Nishuy52/iex-coral-datalogger/images/steps/2023_indicator-on1000ufcap_900pixw.jpg

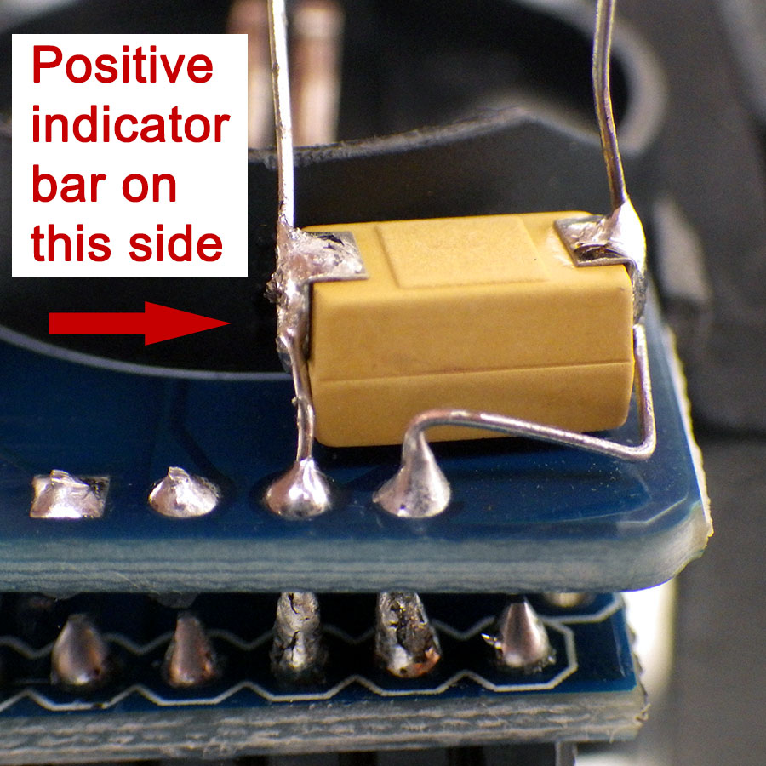
images/steps/2023_indicator-on1000ufcap_900pixw.jpg
