Nishuy52/iex-coral-datalogger/images/steps/pm4_clipresetswitch_900pixwsq.jpg

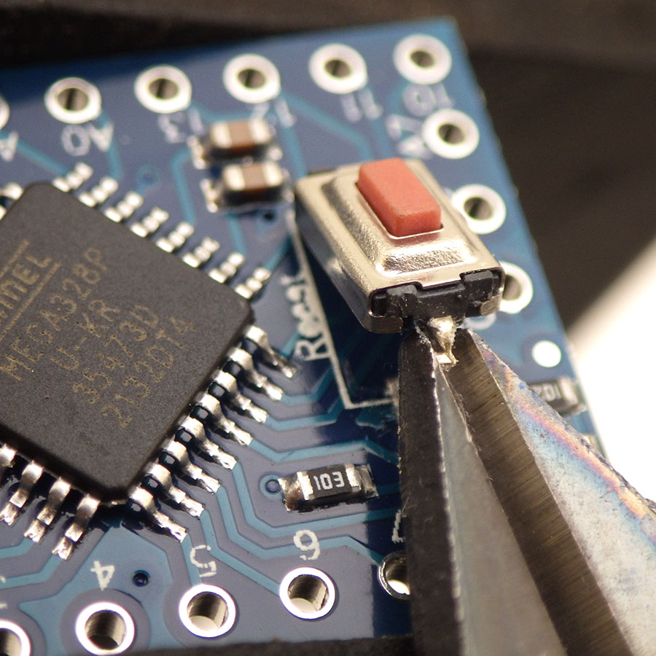
images/steps/pm4_clipresetswitch_900pixwsq.jpg
