Nishuy52/iex-coral-datalogger/images/steps/prom_headerpins_640pixw.jpg

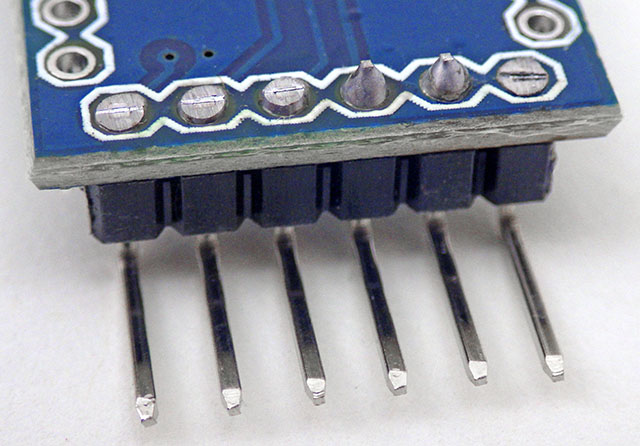
images/steps/prom_headerpins_640pixw.jpg
