Nishuy52/iex-coral-datalogger/2-Part_Logger_DEPLOY/2-Part_Logger_DEPLOY.ino

// 2-Part logger code by Edward Mallon - modified 2023 for e360 course at Northwestern University
// https://thecavepearlproject.org/2022/03/09/powering-a-promini-logger-for-one-year-on-a-coin-cell/
/*
This program supports an ongoing series of DIY 'Classroom Logger' tutorials from the Cave Pearl Project. 
The goal is to provide a starting point for self-built student projects in environmental monitoring.
This low power 2-module iteration runs from a CR2032 coin cell and uses EEprom memory to store sensor readings. 
Data download & logger control are managed through the IDE's serial monitor window at 500000 baud. 
The logger WILL NOT START until those serial handshakes are completed via a UART connection.
The most important rule to follow when adding new sensors is that this code can only accept 1, 2, 4, 8 or 16 sensorBytesPerRecord.
These 'powers of 2' fit in the I2C buffer AND divide evenly into the EEproms hardware page size to prevent page wrap-arounds.

The only library you MUST INSTALL for the minimum configuration of Promini & RTC module is LowPower [by LowPowerLab]
--------------------------------------------------------------------------------------------------------------------
this can be INSTALLED via the Library Manager or from https://github.com/LowPowerLab/LowPower

The following sensors require library installations before they can be used:
---------------------------------------------------------------------------
  BH1750 LUX sensor uses hp_BH1750  [by Stefan Armborst] via Lib Manager OR from https://github.com/Starmbi/hp_BH1750

  Sht30 Humidity sensor uses SHT85  [by Rob Tillaart] via Lib Manager OR from https://github.com/RobTillaart/SHT85/tree/master

  BMP280 uses BMP280_DEV  [by Martin Lindupp] which is available through the Lib Manager although the repo seems to have disappeared from github(?)

  BME280 (includes RH%) uses forcedBMX280  [by soylentOrange] which is available through the Lib Manager
  OR from https://github.com/soylentOrange/Forced-BMX280/tree/master NOTE that this library also works with the BMP280
  if you enable only recordBMEtemp_2byteInt and/or recordBMEpressure_2byteInt

*/

//++++++++++++++++++++++++++++++++++++++++++++++++++++++++++++++++++++++++++++++++   
//++++++++++++++++++++++++++++++++++++++++++++++++++++++++++++++++++++++++++++++++
// CURRENT 328p internal eeprom memory locations in use for start-up information
//++++++++++++++++++++++++++++++++++++++++++++++++++++++++++++++++++++++++++++++++   
//++++++++++++++++++++++++++++++++++++++++++++++++++++++++++++++++++++++++++++++++
/*
(0-3)     logger START TIME in unixtime (for reconstructiong timestamps later in sendSerial)
(4)       SampleIntervalMinutes
(5)       SampleIntervalSeconds
(6-9)     InternalReferenceConstant for calc. rail voltage from ADC in readRailVoltage
(10)      RTCagingOffset [adjusting by 3 compensates for ~ 1second of drift per month]
(12-15)   4byte UNIXtime of last time RTC was set by startMenu_setRTCtime - for drift tracking
(20-23)   NOT USED (yet) Sensor starting paramaters usually stored from (24) onwards

FOUR 100-CHARACTER 'text' info fields get stored in 328p internal eeprom:
Logger info:            64 to 164
Deployment info:        165 to 265
Calibration constants:  266 to 366
Site info:              367 to 467

These are output to screen by void setup_sendboilerplate2serialMonitor() when logger starts up
BUT you can store 'any' text in these fields, notes to self, normalization constants, etc
Note: we still have upper 512 bytes of 328p 1k eeprom availible for OLED screen fonts, etc.
// https://thecavepearlproject.org/2020/11/15/adding-two-oled-displays-to-your-arduino-logger-with-no-library/
*/

//++++++++++++++++++++++++++++++++++++++++++++++++++++++++++++++++++++++++++++++++   
//++++++++++++++++++++++++++++++++++++++++++++++++++++++++++++++++++++++++++++++++
// STEP0 :
// Create SENSOR definitions HERE to match the sensors you added to the logger
// Use these as global controls to enable/disable sensor code with #ifdef & #endif

// POWERS OF TWO rule: sensorBytesPerRecord for the enabled sensor combination MUST TOTAL 1,2,4,8 or 16
// IF you see a repeating error at download time it's probably because you violated that rule

//++++++++++++++++++++++++++++++++++++++++++++++++++++++++++++++++++++++++++++++++   
//++++++++++++++++++++++++++++++++++++++++++++++++++++++++++++++++++++++++++++++++

// LowestBattery & RTC_Temperature are the 2 byte 'base values' which are usually recorded with every sensor reading (as they require no extra sensor hardware beyond the logger itself)
#define logLowestBattery_1byte           // 1-byte (compressed): saves LowestBattery voltage recorded during EEprom saves
#define logRTC_Temperature_1byte         // 1-byte: the RTC's internal 0.25°C resolution temperature sensor

//Pressure sensor:
//#define readBMP280_Temp_2byte            // 2-bytes  // IF you enable all three BMP or BME outputs
//#define readBMP280_Pressure_2byte        // 2-bytes  // you will need two more bytes for an 8-byte record: try adding logLowestBattery_1byte & logRTC_Temperature_1byte 
//#define recordBMP280_Altitude_2byte      // 2-bytes: calculated by library

#define readD7resistorwD6ref_2byte       // NTC? 2-bytes: ohms // for explanation of the method for reading analog resistance with digital pins see
//#define readD9resistorwD6ref_2byte       // LDR? 2-bytes: ohms // https://thecavepearlproject.org/2019/03/25/using-arduinos-input-capture-unit-for-high-resolution-sensor-readings/
                                           // 2022 note: 10k refference resistor on D6, NTC on D7, 300Ω on D8, LDR on D9 - does not match newer 2023 e360 NTC connections
 //Light/Lux sensor:
#define readBh1750_LUX_2byte             // 2-bytes: NOTE: raw sensor output gets converted to Lux during download

//Infrared Motion sensor:                  // AM312 typically adds 10-15uA to sleep current
//#define PIRcountPerInterval_2byte  // 2-bytes:  PIR is just another interrupt generating sensor, saves # of PIR HIGH events in a specified sample interval. Do not enable this with PIRtriggersReadings_4byte - choose one or the other

//#define PIRtriggersReadings_4byte          // 4-bytes for Unix Timestamp saved every pass: Do not enable this with PIRcountPerInterval_2byte - choose one or the other
// DOES NOT use the regular RTC-alarm based sampling interval but instead records the seconds elapsed between EVERY PIR trigger event in a uint32_t long variable [uint16_t would overflow at ~18 hours]
// PIRtriggersReadings_4byte usually enabled with four other bytes of sensor data [for a total of 8 bytes per record] OR with another 12 bytes of sensor data for a total of 16 bytes per record.
// WARNING this can use alot of memory very quickly if PIR is triggered frequently! - recommend use with larger eeprom memory attached


//#define logCurrentBattery_2byte          // RARELY USED - not 1byte compressed like LowestBattery, primarily included as a powers-of-2 balancing option
//#define logFreeVariableMemory_2byte      // RARELY USED - primarily included as a powers-of-2 rule balancing option that does not rely on any external sensors

//#define readSi7051_Temp_2byte            // 2-bytes: used for NTC calibration - does not require a library, functions for si7051 at end of program

//#define readSht3x_Temp_2byte             // 2-bytes
//#define readSht3x_Humidity_2byte         // 2-bytes

#define recordBMEtemp_2byteInt           // 2-byte NOTE: works with both BMP & BME
//#define recordBMEpressure_2byteInt       // 2-byte NOTE: works with both BMP & BME
//#define recordBMEhumidity_2byteInt       // 2-byte ONLY if BME 280 connected!

//#define OLED_64x32_SSD1306               // not a sensor, but enabled with define to include needed library - requires 1000uF rail cap to smooth noise from 1306 charge pump!

// Default EEprom: 0x57 & 4096 here saves data into the 4k eeprom on the RTC module:
//#define EEpromI2Caddr 0x57                    // Run a bus scanner to check where your eeproms are https://github.com/RobTillaart/MultiSpeedI2CScanner
//#define totalBytesOfStorage 4096              // Default: 0x57 / 4096bytes to use the 4k eeprom on the RTC module

// Saving to an external 64k AT24C512 I2C EEprom module (Appendix B):
#define EEpromI2Caddr 0x50                    // Run a bus scanner to check where your eeproms are https://github.com/RobTillaart/MultiSpeedI2CScanner
#define totalBytesOfStorage 65536             // AT24C512 64k module

// the Red LED on D13 gets used if BOTH of the following LED #define statements are commented out
//#define LED_r9_b10_g11_gnd12               // enables code for RGB indicator LED // expects a 1k limit resistor on shared GND!
#define LED_GndGB_A0_A2                  // For 2022 2-module build with NO breadboards: red channel leg on led cut, A0gnd Green A1, blue A2, default Red on d13 left in place

#include <Wire.h>       // I2C bus coms library: RTC, EEprom & Sensors
#include <EEPROM.h>     // note: requires default promini bootloader (ie NOT optiboot)
#include <avr/power.h>  // library for shutting down 328p chip peripherals to lower runtime current
#include <avr/sleep.h>  // provides SLEEP_MODE_ADC to lower current during ADC readings in readRailVoltage() function
#include <LowPower.h>   // this library NEEDS TO BE INSTALLED via the LIBRARY MANAGER for interval & battery recovery sleeps
                        // OR can be downloaded from LowPowerLab's repo (https://github.com/LowPowerLab/LowPower)

// Ref, Interval & Echo are reset via serial monitor input - so the values here don't matter
//-------------------------------------------------------------------------------------------------
int32_t InternalReferenceConstant = 1126400;  // default = 1126400L = 1100mV internal vref * 1024 // gets changed in setup via serial menu input option later
                                              // adding/subtracting 400 from the constant raises/lowers the 'calculated' result from readRailVoltage() by ~1 millivolt,
                                              // simply read the rail with a DVM while running on UART power and change the constant until the calculation is accurate
int8_t RTCagingOffset = 0;                    // stores -127 to +128 in the same two complement format that the register in the RTC uses
uint8_t SampleIntervalMinutes = 15;           // Allowed values: 1,2,3,5,10,15,20,30 for both - must divide equally into 60!
uint8_t SampleIntervalSeconds = 0;            // minutes must be zero for intervalseconds, seconds must be zero for intervalMinutes
                                              // NOTE: Make sure your sensor readings don't take longer than your sample interval!
                                              // If you over-run your alarm because the sensor took too long you will have to wait 24hours for next wakeup

bool ECHO_TO_SERIAL = false;                  // true enables multiple print statements throughout the code via if(ECHO_TO_SERIAL){} // also starts the run with no interval sync delay so timestamps are misaligned
bool displayMoreOptions = false;              // Flag toggle between Setup and Runtime Menus in void setup_displayStartMenu()

// most VARIABLES below this point stay the SAME on all machines:
//---------------------------------------------------------------------------
#define fileNAMEonly (strrchr(__FILE__, '/') ? strrchr(__FILE__, '/') + 1 : strrchr(__FILE__, '\\') ? strrchr(__FILE__, '\\') + 1 : __FILE__) //from: https://stackoverflow.com/questions/8487986/file-macro-shows-full-path
const char compileDate[] PROGMEM = __DATE__;  //  built-in function in C++ makes text string: Jun 29 2023
const char compileTime[] PROGMEM = __TIME__;  //  built-in function in C++ makes text string: 10:04:18

#define EEpromI2Caddr 0x50                    // Run a bus scan to check where your eeproms are https://github.com/RobTillaart/MultiSpeedI2CScanner
#define totalBytesOfStorage 65536       // external AT24C512 64k EEprom module
// Default onboard EEprom on RTC module: 0x57 & 4096 // 32k Module: 0x50 & 32768
uint8_t sensorBytesPerRecord = 0;             // INCREMENTED at the beginning of setup to match #defined sensors. MUST divide evenly into EEprom Page buffer AND fit inside I2C buffer
uint32_t EEmemPointer = 0;                   // counter that advances through the EEprom memory locations by sensorBytesPerRecord at each pass through the main loop

#ifdef logFreeVariableMemory_2byte
uint16_t freeVariableMemory = 0;              // for debugging or powers of two memory balancing
#endif

//defines & variables for ADC & readRailVoltage() function
//------------------------------------------------------------------------------
uint16_t CurrentBattery = 0;
uint16_t LowestBattery = 5764;                                  
uint16_t systemShutdownVoltage = 2795;        // MUST be > BrownOutDetect default of 2775mv (which is also the EEprom voltage limit)
byte default_ADCSRA,default_ADMUX;            // stores default ADC control register settings for peripheral shut down
byte set_ADCSRA_2readRailVoltage, set_ADMUX_2readRailVoltage; // stores custom settings for readRailVoltage() via 1.1 internal band gap reference
volatile uint8_t adc_interrupt_counter;       // incremented in readADCLowNoise ISR to calculate average of multiple ADC readings
#define NOP __asm__ __volatile__ ("nop\n\t")  //https://forum.arduino.cc/index.php?topic=43333.0

//defines & variables for DS3231 RTC
//------------------------------------------------------------------------------
#define RTC_TempRangeOffset 80  // 80 shifts 63degree range of 1byte encoding by +(80/4)C to handle COLD temps: -20C to +43.5C
                                // change this Offset to 40 for WARMER climate deployments to set the range to: -10C to +53.5C

#define rtcAlarmInputPin 2                    // DS3231's SQW output is connected to interrupt0 pin D2 on the ProMini
#define DS3231_ADDRESS     0x68               // this is the I2C bus address of our RTC chip
#define DS3231_STATUS_REG  0x0F               // reflects status of internal operations
#define DS3231_CONTROL_REG 0x0E               // enables or disables clock functions
#define DS3231_TMP_UP_REG  0x11               // temperature registers (upper byte 0x11 & lower 0x12) gets updated every 64sec
#define DS3231_AGING_OFFSET_REG 0x10          // Aging offset register
uint8_t AlarmSelectBits;                      // sets which parts of time to use or ignore for nxt alarm // ALRM1_SET bits and ALRM2_SET are 0b1000 and 0b0111 respectively.
uint8_t t_second,t_minute,t_hour,t_day,t_month;     // current time variables populated by calling RTC_DS3231_getTime()
uint16_t t_year;                              //current year //note: yOff = raw year to which you need to add 2000
uint8_t Alarmday,Alarmhour,Alarmminute,Alarmsecond; // calculated variables for setting next alarm
volatile boolean rtc_INT0_Flag = false;       // used in startup time sync delay //volatile because it's changed in an ISR // rtc_d2_alarm_ISR() sets this boolean flag=true when RTC alarm wakes the logger
int16_t rtc_TEMP_degCx4 = 0;                  // NOTE saved rtc_TEMP is reduced to only one BYTE
bool DS3231_PowerLossFlag = false;

// temporary 'buffer' variables only used during calculations
//------------------------------------------------------------------------------
bool booleanBuffer;                           // boolean for functions that return a true/false or 1/0
uint8_t byteBuffer1 = 9;                      // 1-byte (8 bit) type = unsigned number from 0 to 255
uint8_t byteBuffer2 = 9;                      // note: uint8_t is the same as byte variable type
int16_t int16_Buffer = 9999;                  // 2-byte from -32,768 to 32,767
uint16_t uint16_Buffer= 9999;                 // 2-byte from 0 to 65535
int32_t int32_Buffer = 9999;                  // 4-byte from -2,147,483,648 to 2,147,483,647
uint32_t uint32_Buffer= 9999;                 // 4-byte from 0 to 4,294,967,295 //used for millis() timing
float floatBuffer = 9999.99;                  // for float calculations
uint8_t hiByte,loByte;                        // for splitting 16-byte integers during EEprom save

//+++++++++++++++++++++++++++++++++++++++++++++++++++++++++++++++++++++++++++++++   
//+++++++++++++++++++++++++++++++++++++++++++++++++++++++++++++++++++++++++++++++
// STEP1 : #include sensor libraries, create GLOBAL variables, #defines etc. HERE
//+++++++++++++++++++++++++++++++++++++++++++++++++++++++++++++++++++++++++++++++   
//+++++++++++++++++++++++++++++++++++++++++++++++++++++++++++++++++++++++++++++++

#if defined(PIRcountPerInterval_2byte) || defined(PIRtriggersReadings_4byte)
uint16_t d3_INT1_eventCounter = 0;
volatile boolean d3_INT1_Flag = false; 
#endif

#ifdef PIRtriggersReadings_4byte
//--------------------------------
uint32_t currentPIRtriggerTime;      // not saved, but calculated for specific lab activities
uint32_t previousPIRtriggerTime;     // not saved, but calculated for specific lab activities
uint32_t d3_INT1_elapsedSeconds = 0; // not saved, but calculated for specific lab activities
#endif

#ifdef readD7resistorwD6ref_2byte 
//--------------------------------
  uint32_t D7resistor_NewReading;           // max of 65535 limits our ability to measure 10kNTC at temps below zero C!
  // although the timing code is capped at 65535 the variable needs to be uint32_t to accomodate
  // because clock ticks are about 1/3 of actual ohms & calculation can reach values of about 150k ohms 
#endif

#ifdef readD9resistorwD6ref_2byte 
//--------------------------------
  uint32_t D9resistor_NewReading;           // 65535 limit
#endif
#if defined(readD7resistorwD6ref_2byte) || defined(readD9resistorwD6ref_2byte)
//------------------------------------------------
  #define referenceResistorValue 10000UL    //  ARBITRARY value that should be 'close' to actual ohms but precise is not required  //https://hackingmajenkoblog.wordpress.com/2016/08/12/measuring-arduino-internal-pull-up-resistors/
  volatile boolean triggered;               //  volatiles needed for all digital pin reading of resistance:        
  volatile uint16_t timer1CounterValue;     //  prepareForInterrupts(), ISR (TIMER1_OVF_vect), ISR (TIMER1_CAPT_vect), ReadD6riseTimeOnD8
#endif

#ifdef readBh1750_LUX_2byte 
//------------------------------------------------------------------------------
  #include <hp_BH1750.h>                    // by Stefan Armborst via Lib Manager OR from https://github.com/Starmbi/hp_BH1750 returns the sensor to sleep automatically after each read & supports auto-ranging.
  hp_BH1750 bh1750;                         // Instantiate a BH1750FVI library object
  uint16_t lux_BH1750_RawInt;               // raw reading before conversion to lux // 2-byte, 0 to 65535
  #define Bh1750_Address 0x23
#endif

#if defined(readSht3x_Temp_2byte) || defined(readSht3x_Humidity_2byte)
//---------------------------------------------------------------
// https://sensirion.com/media/documents/213E6A3B/63A5A569/Datasheet_SHT3x_DIS.pdf
// SHT30 Accuracy ±0.2°C, ±2%RH
// idle state(single shot mode@3v) 0.2uA,  Supply current: Measuring 600uA, Heater power 33mW 
// Soft reset time 1.5 ms, Measurement duration 15 ms (slow)  4 ms (fast)
// The SHT85 is protocol in this library is compatible with the SHT3x series of sensors

  #include <SHT85.h> // https://github.com/RobTillaart/SHT85/tree/master
  #define ShtRH_ADDRESS   0x44              // The SHT3x has two I2C address options: 0x44 & 0x45
  float Sht3x_Temp_degC,Sht3x_RH_percent;   // floats converted to integer before saving - preserving two decimal places
  SHT85 sht3x(ShtRH_ADDRESS);
  //uint16_t Sht3x_Temp_RawInt,Sht3x_RH_RawInt; //library also supports raw integer output
#endif

#if defined(readBMP280_Temp_2byte) || defined(readBMP280_Pressure_2byte) || defined(recordBMP280_Altitude_2byte)
//-----------------------------------------------------------------------------------
  #include <BMP280_DEV.h>                   // Include the BMP280_DEV.h library  // NOTE: this library has disappeared from github?
  BMP280_DEV bmp280;                        // Instantiate (create) a BMP280_DEV object and set-up for I2C operation
  #define BMP280_Address 0x76
  float Bmp280_Temp_degC, Bmp280_Pr_mBar, Bmp280_altitude_m;  // Variables for sensor output
  // NOTE these floats get converted into 16-bit ints before saving to EEprom
#endif

#if defined(recordBMEtemp_2byteInt) || defined(recordBMEpressure_2byteInt) || defined(recordBMEhumidity_2byteInt)
//-----------------------------------------------------------------------------------
  #include <forcedBMX280.h>  // install this through the library manager in the IDE
  // from https://github.com/soylentOrange/Forced-BMX280/blob/master/examples/BME280_full_example/BME280_full_example.ino
  // ctrl_meas - see datasheet section 5.4.5 // forced mode: ctrl_meas[0..1] 0b01 (0b11 for normal and 0b00 for sleep mode)
  // pressure oversampling x 1: ctrl_meas[4..2] 0b001
  // temperature oversampling x 1: ctrl_meas[7..5] 0b001
  // humidity does not have oversampling
  
  ForcedBME280 climateSensor = ForcedBME280();
  int32_t Bmx_temperature;  // current temperature with 2 decimal places ALREADY embedded in the integer by the library
  uint32_t Bmx_pressure;    // current pressure           "
  uint32_t Bme_humidity;    // current humidity           "
#endif

#ifdef readSi7051_Temp_2byte 
//------------------------------------------------------------------------------
  // we are not using a library - init and read functions for si7051 at end of program
  uint16_t TEMP_si7051=0;                  // NOTE sensors output overruns this uint16_t at 40C!
  #define Si7051_Resolution 0b00000000     // 0b00000000 = 14-bit (0.01 C rez), 13 bit = 0b10000000 (0.02 C rez), 12 bit = 0b00000001 (0.04 C rez),11 bit = 0b10000001 (0.08 C rez)
  #define Si7051_Address 0x40
#endif

#ifdef OLED_64x32_SSD1306
//------------------------------------------------------------------------------
#include <SSD1306Ascii.h>       // https://github.com/greiman/SSD1306Ascii
#include <SSD1306AsciiWire.h>   // tells SSD1306Ascii.h to use default wire library
#define oled_I2C_Address 0x3C   // 0X3C+SA0 can be 0x3C or 0x3D
SSD1306AsciiWire oled;          // declare oled object
#endif


//======================================================================================================================
//======================================================================================================================
//======================================================================================================================
//*   *   *   *   *   *   *   *   *   *   *   SETUP   *   *   *   *   *   *   *   *   *   *   *   *   *   *   *   *   * 
//======================================================================================================================
//======================================================================================================================
//======================================================================================================================
// NOTE: problems in setup usually call the error_shutdown() function which shuts down the logger

void setup () {

  // --- early serial init: bring up the UART BEFORE any I2C so a stuck bus
  //     (e.g. a miswired sensor holding SDA/SCL low) can't blank the monitor ---
  Serial.begin(500000);                          // 500000 baud = max for 8MHz
  Serial.println(F("\nBooting... initialising I2C / RTC"));  Serial.flush();

//+++++++++++++++++++++++++++++++++++++++++++++++++++++++++++++++++++++++++++++++
//+++++++++++++++++++++++++++++++++++++++++++++++++++++++++++++++++++++++++++++++
// STEP2 : Adjust the sensorBytesPerRecord variable to match the #bytes in your
// sensor variables that will be saved to EEprom at each sampling interval
// sensorBytesPerRecord must be 1,2,4,8 or 16 bytes because of EEprom page boundaries
//+++++++++++++++++++++++++++++++++++++++++++++++++++++++++++++++++++++++++++++++   
//+++++++++++++++++++++++++++++++++++++++++++++++++++++++++++++++++++++++++++++++
  
  #ifdef logLowestBattery_1byte
    sensorBytesPerRecord = sensorBytesPerRecord + 1;            // NOW INDEX-compressed to 1-Byte [with slight loss of resolution]
  #endif
  #ifdef logRTC_Temperature_1byte
    sensorBytesPerRecord = sensorBytesPerRecord + 1;            // NOW INDEX-compressed to 1-Byte of eeprom storage
  #endif

  #ifdef PIRcountPerInterval_2byte
    sensorBytesPerRecord = sensorBytesPerRecord + 2;            //  two-byte integer counts Rising of output channel of PIR sensor
  #endif

  #ifdef PIRtriggersReadings_4byte
    sensorBytesPerRecord = sensorBytesPerRecord + 4;            //  4-byte integer: d3_INT1_elapsedSeconds
  #endif
  
  #ifdef readD7resistorwD6ref_2byte 
    sensorBytesPerRecord = sensorBytesPerRecord + 2;            //  two-byte integer: NTC ohms
  #endif
  #ifdef readD9resistorwD6ref_2byte
    sensorBytesPerRecord = sensorBytesPerRecord + 2;            //  two-byte integer: LDR ohms
  #endif

  #ifdef readBh1750_LUX_2byte
    sensorBytesPerRecord = sensorBytesPerRecord + 2;           // two-byte integer for RAW reading before conversion to lux
  #endif
 
  #ifdef readSht3x_Temp_2byte
    sensorBytesPerRecord = sensorBytesPerRecord + 2;            // two-byte integer 
  #endif
  #ifdef readSht3x_Humidity_2byte
    sensorBytesPerRecord = sensorBytesPerRecord + 2;            // two-byte integer 
  #endif
  
  #ifdef readBMP280_Temp_2byte
    sensorBytesPerRecord = sensorBytesPerRecord + 2;            // two-byte integer 
  #endif
  #ifdef readBMP280_Pressure_2byte
    sensorBytesPerRecord = sensorBytesPerRecord + 2;            // two-byte integer 
  #endif
  #ifdef recordBMP280_Altitude_2byte
    sensorBytesPerRecord = sensorBytesPerRecord + 2;            // two-byte integer 
  #endif

  #ifdef recordBMEtemp_2byteInt
    sensorBytesPerRecord = sensorBytesPerRecord + 2;            // two-byte integer 
  #endif
  #ifdef recordBMEpressure_2byteInt
    sensorBytesPerRecord = sensorBytesPerRecord + 2;            // two-byte integer 
  #endif
  #ifdef recordBMEhumidity_2byteInt
    sensorBytesPerRecord = sensorBytesPerRecord + 2;            // two-byte integer 
  #endif
  
  #ifdef logCurrentBattery_2byte
    sensorBytesPerRecord = sensorBytesPerRecord + 2;            // two-byte integer
  #endif
  #ifdef logFreeVariableMemory_2byte
    sensorBytesPerRecord = sensorBytesPerRecord + 2;            // two-byte integer
  #endif
  
  #ifdef readSi7051_Temp_2byte
    sensorBytesPerRecord = sensorBytesPerRecord + 2;            // two-byte integer  
  #endif
  

// General Startup housekeeping: Set UNUSED digital pins to a known state at startup to reduce current & noise
//------------------------------------------------------------------------------------------------------------

  // set UNUSED digital pins to INPUT/HIGH so EMI noise does not toggle the pin & draw current
    for (int i = 3; i <=8; i++) { pinMode(i,INPUT); digitalWrite(i,HIGH);} 

  #ifdef LED_r9_b10_g11_gnd12                       // we will use INPUT & PULLUP resistor to PIP the leds to reduce current
    for (int i = 9; i <=12; i++) { pinMode(i, INPUT); digitalWrite(i, LOW); }
    pinMode(12, OUTPUT);                            //the common ground line on our RGB led must OUTPUT to allow current
  #else
    for (int i = 9; i <=12; i++) { pinMode(i,INPUT); digitalWrite(13,HIGH);}
  #endif

   pinMode(13, INPUT); digitalWrite(13,LOW);        // turn of D13 onboard red LED by setting D13 to INPUT & LOW

  #ifdef LED_GndGB_A0_A2
    bitClear(PORTC,1); bitClear(DDRC,1);            // A1 [green] LED LOW & INPUT
    bitClear(PORTC,2); bitClear(DDRC,2);            // A2 [Blue] LED LOW & INPUT
    bitClear(PORTC,0); bitSet(DDRC,0);              // A0 common cathode LED GND pin: LOW & OUTPUT
  #endif //LED_GndGB_A0_A2
                     
  //Disable UNUSED Peripherals to save power - restart them later when needed - At 3V @ 25°C, the ADC consumes ~87µA so we disable it to save power
    SPCR = 0; power_spi_disable();                  // stop the peripheral clock with SPCR = 0 BEFORE calling power_spi_disable(); -same applies to the ADC
    power_timer1_disable(); power_timer2_disable(); // NOTE: DON'T mess with timer0! - other peripherals like the I2C bus require Timer0 operating
    bitSet(ACSR,ACD);                               // Disables the analog comparator on AIN0(PD6) and AIN1(PD7)by setting the ACD bit (bit 7) of the ACSR register to one. analog comparator draws ~51µA.


// ADC Configuration: default & modified control register settings saved into storage variables
//------------------------------------------------------------------------------------------------------------

  digitalWrite(A3,LOW); bitSet (DIDR0, ADC3D);      // disable digital input on A3
  analogReference(DEFAULT); analogRead(A3);         // sets the ADC channel to A3 input pin
  default_ADCSRA = ADCSRA; default_ADMUX = ADMUX;   // Saves the DEFAULT ADC control registers into byte variables so we can restore those ADC control settings later

  bitWrite(ADCSRA,ADPS2,1);bitWrite(ADCSRA,ADPS1,1);bitWrite(ADCSRA,ADPS0,0);     // 64 (default) prescalar @ 8MHz/64 = 125 kHz, =~104uS/ADC reading
  set_ADCSRA_2readRailVoltage = ADCSRA;             // store the modified ADCSRA register values for use in readRailVoltage() function & while saving eeprom data

  // modify ADC settings to reading the battery/rail voltage using the internal 1.1v reference inside the 328p chip 
  ADMUX = (0 << REFS1) | (1 << REFS0) | (0 << ADLAR) | (1 << MUX3) | (1 << MUX2) | (1 << MUX1) | (0 << MUX0); // from https://provideyourown.com/2012/secret-arduino-voltmeter-measure-battery-voltage/
  set_ADMUX_2readRailVoltage = ADMUX;               // store modified ADMUX register values in a variable for use in readRailVoltage()

  ADMUX = default_ADMUX;                            //restore the default
  ADCSRA = 0; power_adc_disable();                  //turn off the ADC to save power At 3V @ 25°C, the ADC consumes ~87µA
  

// Configure the DS3231 Real Time Clock control registers for coincell powered operation
//------------------------------------------------------------------------------------------------------------
  Wire.begin();                                     // Start the I2C bus // enables internal 30-50k pull-up resistors on SDA & SCL by default
  Wire.setWireTimeout(25000, true);                 // 25ms TWI timeout + auto bus-reset: a stuck I2C line fails fast instead of hanging setup() forever

  if(totalBytesOfStorage==4096){ Wire.setClock(100000UL);}
    else {Wire.setClock(400000UL);}
  // Set the I2C bus speed to 100 kHz - but only because the default 4k eeprom is so OLD
  // NOTE: you can speed up to 400khz for the DS3231 and other I2C device coms
  // later on the in the main looploop
  
  DS3231_PowerLossFlag = i2c_readRegisterByte(DS3231_ADDRESS, DS3231_STATUS_REG) >> 7; //0Fh BIT 7 is OSF: Oscillator Stopped Flag
  // i2c_setRegisterBit function requires: (deviceAddress, registerAddress, bitPosition, 1 or 0)
  i2c_setRegisterBit(DS3231_ADDRESS, DS3231_STATUS_REG, 3, 0);  // disable the 32khz output  pg14-17 of datasheet  // This does not reduce the sleep current but can't run because we cut VCC
  i2c_setRegisterBit(DS3231_ADDRESS, DS3231_CONTROL_REG, 6, 1); // 0Eh Bit 6 (Battery power ALARM Enable) - MUST set to 1 for wake-up alarms when running from the coincell bkup battery
  i2c_setRegisterBit(DS3231_ADDRESS, DS3231_CONTROL_REG, 7, 0); // Enable Oscillator (EOSC).  This bit is clear (logic 0) when power is first applied.  EOSC = 0 IS REQUIRED with OUR LOGGER DESIGN:
                                                                // when EOSC (bit7) is 0, the RTC oscillator continues running during battery powered operation. Otherwise it would stop.

  RTC_DS3231_ResetBothAlarmFlags();                               // stops RTC from holding the D2 interrupt line low if system reset just occured 
  digitalWrite(2, LOW);  pinMode(2, INPUT);                     // D2 INPUT & D2 pullup off because it is not requried with 4k7 hardware pullups on the RTC module
  bitSet(EIFR,INTF0); bitSet(EIFR,INTF1);                       // clears any previous trigger-flags inside the 328p processor for interrupt 0 (D2) &  interrupt 1 (D3)

  //DS3231 does not have any non-volatile memory so all of the internal registers reset to default if power is lost - so we store this in the 328p eeprom
  RTCagingOffset = EEPROM.read(10);                             // int8_t can store from -127 to +128
      if((RTCagingOffset<-128) || (RTCagingOffset>127)){        // if value stored in eeprom is outside normal operating parameters
        RTCagingOffset=0;                                       // then resets it to the 0 default 
        EEPROM.update(10,0);                                    // and store that default back in the eeprom
        }
  i2c_writeRegisterByte(DS3231_ADDRESS,DS3231_AGING_OFFSET_REG,RTCagingOffset); delay(15);
  RTCagingOffset = i2c_readRegisterByte(DS3231_ADDRESS,DS3231_AGING_OFFSET_REG);  //RTCagingOffset variable in matching twos complement format as register
  // NOTE the RTCagingOffset value gets displayed as part of the serial menu
  
// Check Previous run Parameters stored in 328p eeprom [ update happens only on 1st run of a brand new logger]
//------------------------------------------------------------------------------------------------------------
  EEPROM.get(6,InternalReferenceConstant);                      //in this case .get is reading 4 consecutive bytes into the long (32bit) integer InternalReferenceConstant
  if((InternalReferenceConstant<1000000) || (InternalReferenceConstant>1228800)){ //if value stored in eeprom is outside normal operating parameters
    InternalReferenceConstant=1126400;                          // then re-sets it to the default 1126400
  EEPROM.put(6,InternalReferenceConstant);}                     // and store that default back in the eeprom

  SampleIntervalMinutes = EEPROM.read(4);                       // retrieve 'previous' sampling interval data stored in the CPU's internal 1024 bytes of eeprom space
  SampleIntervalSeconds = EEPROM.read(5);                       // these numbers will be random the first time the logger is run because the EEprom memory locations are empty
  if((SampleIntervalMinutes>60) || (SampleIntervalSeconds>30))  //if values read from eeprom are outside allowed maximums then reset to 'safe' default values
    { SampleIntervalMinutes=15;SampleIntervalSeconds=0;
      EEPROM.update(4,SampleIntervalMinutes); 
      EEPROM.update(5,SampleIntervalSeconds); }                 // .update is the same as .put, except that it only writes the data if there is a change - eeprom has a limited # of write cycles

//===============================================================================================
// Logger Configuration Menu via Serial Monitor  [loops for 8 minutes or until START is selected]
//===============================================================================================
  // NOTE: Opening the serial monitor always "restarts" the Arduino
  // Serial.begin(500000) already called at the top of setup() - moved there so a stuck I2C bus can't blank the monitor
  setup_sendboilerplate2serialMonitor();                        // send currently running code fileNAME, deployment details to monitor
//----------------------------------------------------------------------------------------

  setup_displayStartMenu();                                     // see this function & linked sub functions after end of MAIN loop
//----------------------------------------------------------------------------------------

// check if ECHO is on & confirm with user that's OK
  if(ECHO_TO_SERIAL){                                           //confirmation check so we don't waste battery power
  Serial.println(F("Serial Output ON! - NOT compatible w bat. powered operation. Disable? y/n"));
                                                                //DO NOT ENABLE ECHO_TO_SERIAL during battery powered logger operation or system wastes a lot of power waiting for a serial handshake that never arrives
  booleanBuffer = true; byteBuffer1 = 0;
    while (booleanBuffer) {
        if (Serial.available()) {byteBuffer1 = Serial.read();}  //.read captures only character at a time from the serial monitor window
        
        switch (byteBuffer1) {
          case 'y': 
            ECHO_TO_SERIAL = !ECHO_TO_SERIAL; booleanBuffer = false; break;
          case 'n': 
            booleanBuffer = false; break;
          default: break;
              }       // terminates switch case
        }             // terminates while(booleanBuffer)
   }                  // terminates if(ECHO_TO_SERIAL)
   
  Serial.print(F("Serial "));Serial.println(ECHO_TO_SERIAL ? "ON" : "OFF");  // ? here is short-form of if..else statement which checks the boolean and prints first text if true, second option if false
  Serial.println();

//Final confirmation check before erasing EEprom & starting the logger
  Serial.println(F("Type 'start' (& enter) to clear the EEprom & begin logging"));
  //Serial.println(F("Any other input will shut down the logger"));
  Serial.println(F("PROCEEDING at **this** point will ERASE ALL previous DATA!"));
//------------------------------------------------------------------------------------------------------------
  Serial.println();

  String command="";                                          // any variables delcared in the setup function get deleted at end of setup function
  boolean goFlagReceived = false;                             // so these variables will 'disapear' when we reach the main loop
  Serial.setTimeout(1500);                                  // short window: readString() returns ~1.5s after you type, so no line-ending is needed
  unsigned long startMillis = millis();

do { command = Serial.readString();                  // read serial monitor data into the string until carridge return = \n character
    command.trim();                                              // BULLETPROOF: strip trailing CR/whitespace so 'start' matches under any serial line-ending setting

    // here we are using if statements to check the input instead of the switch / case method used above, goFlagReceived only becomes 'true' with valid input
    if(command.indexOf("start") >= 0){ 
      Serial.print(F("Erasing EEprom: Stay on UART power until done"));
      //------------------------------------------------------------------------------
                
      for (uint32_t memoryLocation=0; memoryLocation<totalBytesOfStorage; memoryLocation+=16){  // loop writes 16-bytes at a time into the I2C buffer
          Wire.beginTransmission(EEpromI2Caddr);
          Wire.write(highByte(memoryLocation));               // sends only the HiByte of the 2-byte integer address
          Wire.write(lowByte(memoryLocation));                // send only the LowByte of the address
          for (byte k=0; k<16; k++) { Wire.write(0xFF);}         // we are loading the I2C buffer with 16 'zeros' each time
          Wire.endTransmission();                             // only at this command does the I2C bus transmission actually occcur

          // here we use modulo to print a progress dots in the serial monitor as the memory erase proceeds // also generates a return when memoryLocation=0
          if ((memoryLocation % 64) == 0){Serial.print(F("."));} // progress bar dot every 64 memory locations // %(modulo) = reminder after division 
          if ((memoryLocation % 4096) == 0){Serial.println();}   // serial printing takes approximately 10 seconds divided by the baud rate, per character
          
          // while loop which polls the eeprom to see if its ready for the next bytes to be written - can't progress past this point until EEprom says Yes
          do{ Wire.beginTransmission(EEpromI2Caddr); }while (Wire.endTransmission() != 0x00);  // endTransmission returns ZERO for successfully ACKnowledgement ONLY when EEprom is READ for more data
          
      }   //terminates: for (int memoryLocation=0; memoryLocation<totalBytesOfStorage; memoryLocation+=16){
     
          Serial.println(); goFlagReceived=true;
          
    } else if(command.indexOf("test") >= 0)                // 'test' is a HIDDEN option not on the displayed menu
           {goFlagReceived=true;}               // 'test' simply skips erasing eeprom: I only use this to make debugging faster
 
  if(goFlagReceived) break;                     // breaks out of the while loop when goFlagReceived=true;
 
}while ((millis() - startMillis) < 200000);     // terminates the do-while after 200 seconds BEFORE loop times out with goFlagReceived=false which leads to logger shutdown

if (!goFlagReceived){                           // if goflag=false then the loop timed out so shut down the logger
      Serial.print(F("Menu Timeout with NO command! "));
      Serial.flush();error_shutdown();          // shut down the logger
}


Serial.print(F("Initializing sensors: "));Serial.flush();
//------------------------------------------------------------------------------------------------------------

//+++++++++++++++++++++++++++++++++++++++++++++++++++++++++++++++++++++++++++++++   
//+++++++++++++++++++++++++++++++++++++++++++++++++++++++++++++++++++++++++++++++
// STEP3 : Initialize your sensor (if needed)
//+++++++++++++++++++++++++++++++++++++++++++++++++++++++++++++++++++++++++++++++   
//+++++++++++++++++++++++++++++++++++++++++++++++++++++++++++++++++++++++++++++++
// this is where you could configure your control registers & usually take a first reading
// often wrapped with    #ifdef Sensor_Address  ...  #endif statements
// RTC is already initialized in setup!

// no initialization needed for readD7resistorwD6ref_2byte or readD9resistorwD6ref_2byte

// BH1750 initialization
//-----------------------
#ifdef readBh1750_LUX_2byte             //using library:  https://github.com/Starmbi/hp_BH1750  
  bh1750.begin(Bh1750_Address); // set address & initialize
      //bh1750.calibrateTiming();     // NOTE: ambient light must be at least 140 lux when calibrateTiming runs!
      //Serial.println(F("BH1750 light sensor MUST be exposed to >150 lux @ startup")); 
      //Serial.println(F("for self-cal or it may freeze randomly. 15 sec = minimum interval for this sensor"));Serial.println();Serial.flush();
  bh1750.start(BH1750_QUALITY_LOW, BH1750_MTREG_LOW); // Quality LOW = fastest readings
      // QUALITY_HIGH -Resolution Mode Measurement Time 120-180 ms depending on light levels
      // QUALITY_LOW  -Resolution Mode Measurement Time 16-24 msec //LOW MTreg:31  resolution lux:7.4, 121557 is highest lux

  Serial.print(F("BH1750 started,"));Serial.flush();
#endif // terminates bh1750 init.

// Sht3x initialization
//-----------------------
#if defined(readSht3x_Temp_2byte) || defined(readSht3x_Humidity_2byte)
//---------------------------------------------------------------
  sht3x.begin(); 
  Serial.print(F("Starting Sht3x"));Serial.flush();
  
  // first reading should be done slowly
  sht3x.requestData(false);  //default () = fast = true blocks 4 (fast) or 15 (slow) milliseconds 
  LowPower.powerDown(SLEEP_30MS, ADC_OFF, BOD_OFF);; // + an extra 2msec to wakeup
  //do{ booleanBuffer = sht3x.dataReady(false); }while(!booleanBuffer); //wait for data ready - this only checks if enough time has passed to read the data. (15 milliseconds)
  sht3x.readData(false);      
  // default () = fast = true blocks 4 (fast) or 15 milliseconds if false = slow
  // The parameter true/false should be the same in requestData() and dataReady()

  //Sht3x_RH_RawInt= sht3x.getRawHumidity();  //raw two-byte representation of humidity directly from the sensor
  //Sht3x_Temp_RawInt = sht3x.getRawTemperature(); //raw two-byte representation of temperature directly from the sensor
  //Sht3x_RH_percent = Sht3x_RH_RawInt * (100.0 / 65535);
  //Sht3x_Temp_degC = Sht3x_Temp_RawInt * (175.0 / 65535) - 45;

  Sht3x_Temp_degC = sht3x.getTemperature();
  Sht3x_RH_percent = sht3x.getHumidity();
  Serial.print(F(" RH%: "));Serial.print(Sht3x_RH_percent,2);  
  Serial.print(F(" T[°C]: "));Serial.print(Sht3x_Temp_degC,2);
  Serial.println();Serial.flush();

  // OTHER commands: from https://github.com/RobTillaart/SHT85/tree/master
  // sht3x.setTemperatureOffset( );  // Offset is defined in degrees Celsius.
  // sht3x.setHumidityOffset( );     // Default offsets are zero for both temperature and humidity. 
  // These functions allows one to adjust them a little. Note there is no limit to the offset so one can use huge values. This allows to use an offset of 273.15 effectively creating °Kelvin instead of Celsius.
  // sht3x.reset(); //(bool hard = false) resets the sensor, soft reset by default. Returns false if it fails.
  // sht3x.heatOff();
    
  // uint16_t stat = sht3x.readStatus();Serial.print(F("Status: \t"));Serial.println(stat, HEX);
  // uint32_t ser = sht3x.GetSerialNumber();Serial.print(F("Serial Num: \t"));Serial.println(ser, HEX);
  // Serial.print(F("LIB_VERSION: \t"));Serial.println(SHT_LIB_VERSION); Serial.flush();
#endif


// BMP280 initialization
//-----------------------
#if defined(readBMP280_Temp_2byte) || defined(readBMP280_Pressure_2byte) || defined(recordBMP280_Altitude_2byte)
  bmp280.begin(BMP280_Address);                             // or bmp280.begin(BMP280_I2C_ALT_ADDR); for sensors at 0x76
      //Options are OVERSAMPLING_SKIP, _X1, _X2, _X4, _X8, _X16 // pg 15 datasheet One millibar = 100 Pa
  bmp280.setPresOversampling(OVERSAMPLING_X4);
      //X2 Low power              17 bit / 1.31 Pa     7.5-8.7msec    3-4µA @ 1 Hz forced mode
      //X4 Standard resolution    18 bit / 0.66 Pa     11.5-13.3ms  7-10µA @ 1 Hz forced mode
      //X8 High resolution        19 bit / 0.33 Pa     19.5-22.5ms  12-18µA @ 1 Hz forced mode
      //X16 Ultra high resolution 20 bit / 0.16 Pa     37.5-43.2ms  24-37µA @ 1 Hz forced mode
  bmp280.setTempOversampling (OVERSAMPLING_X2);
      //X2 Low power              17 bit / 0.0025 °C   // NOTE: Higher levels of Temperature oversampling
      //X4 Standard resolution    18 bit / 0.0012 °C   // provides NO improvement to ACCURACY of pressure readings
      //X8 High resolution        19 bit / 0.0006 °C
      //X16 Ultra high resolution 20 bit / 0.0003 °C
  bmp280.setSeaLevelPressure (1013.25f);                      // default value for altitude calculations
  bmp280.setIIRFilter(IIR_FILTER_OFF); 

//take the first reading (just a throw away reading to load the output registers)
  bmp280.startForcedConversion();                             // time needed here depends on oversampling settings
  LowPower.powerDown(SLEEP_30MS, ADC_OFF, BOD_OFF);;            // 60MSEC = long enough for max rezolution settings
  bmp280.getCurrentMeasurements(Bmp280_Temp_degC,Bmp280_Pr_mBar,Bmp280_altitude_m);

  Serial.print(F("BMP280 started,"));Serial.flush();

#endif // terminates BMP280 init.

// BME280 initialization
//-----------------------
#if defined(recordBMEtemp_2byteInt) || defined(recordBMEpressure_2byteInt) || defined(recordBMEhumidity_2byteInt)
  // NOTE this library defaults to lowest resoulution to save power
  // the NOISE depends on the oversampling and, for pressure and temperature on the filter setting used 
  // noise in temp at x1 oversampling: 0.005 deg C at 25C  [see chapter 3.6]
  // noise in pressure at x1 oversampling: 3.3mbar @x1 but 1.3mbar at x16 at 25C
  // IIR filtering can't be used with one-shot because it requires you to take multiple readings in succession
  
  while (climateSensor.begin()) {Serial.println(F("Waiting for sensor..."));delay(1000);}
  Serial.print("BmE280 ID:0x");
  Serial.print(climateSensor.getChipID(), HEX);
  Serial.println();Serial.flush(); 
#endif // terminates BME280 init.

#ifdef readSi7051_Temp_2byte
//--------------------
  initializeSI7051(); // we are not using a library so you can scroll down to read this function at the end of this program
  // if that function was in an #included library it would usually have an object .prefix something like:  si7051.initialize()
  Serial.print(F("Si7051 started"));Serial.flush();  // if you see this message in the serial monitor you know the sensor did not hang the machine...
#endif

#ifdef OLED_64x32_SSD1306       // using library:  https://github.com/greiman/SSD1306Ascii/blob/master/src/SSD1306Ascii.cpp
  oled.begin(&Adafruit128x64,oled_I2C_Address);
  oled.setFont(System5x7);      // list of other availiable fonts: https://github.com/greiman/SSD1306Ascii/tree/master/src/fonts
  oled.setContrast(64); //The contrast level -range 0 to 255. // LOWER CONTRAST = DIMMER SCREEN = LESS CURRENT
  oled.clear();
  oled.ssd1306WriteCmd(SSD1306_DISPLAYOFF); // switch display off until it is needed
  // NOTE 0.49 inch OLED Display is only 64x32 pixels which ONLY OCCUPIES THE CENTER SQUARE of the SSD1306's 128x64 memory locations
#endif

Serial.println(F("& Starting the logger:"));Serial.flush();

//========================================================================================
// FINAL STARTUP PROCEDURE: is to DELAY the logger until 1st sampling alarm is synchronized
// otherwise you might get a "clipped interval" at the first hour rollover
//========================================================================================
// ALSO saves logger startup time to 328p internal EEprom WHILE tethered to UART for power
// the saved startup time is used later when startMenu_sendData2Serial reconstructs TimeStamps during data download
//========================================================================================

RTC_DS3231_getTime();                     // populates the global variables t_day, t_hour, etc.

  Alarmday = t_day; Alarmhour = t_hour; Alarmminute = t_minute;
  //AlarmSelectBits = 0b00001000;               // A1 Alarm when hours, minutes and seconds match
  //AlarmSelectBits = 0b00000000;               // A1 Alarm when day of month, hours, minutes and seconds match

  if(SampleIntervalSeconds>0){    // NOTE: if the sample interval is in seconds this delay can be VERY short
      Alarmsecond = t_second + 1;    
      do{ Alarmsecond = Alarmsecond + 1;
         }while(Alarmsecond % SampleIntervalSeconds); // all non-zero results considered true // forces alignment

      //bytebuffer1 = delay minutes, bytebuffer2 = delay seconds 
      //the expected delays sent to serial - not actual alarm times
      byteBuffer2 = Alarmsecond - t_second; byteBuffer1 = 0;
      
      if(Alarmsecond>59){
        Alarmsecond = 0; 
        Alarmminute=Alarmminute+1; 
        byteBuffer2 =60-t_second; 
        byteBuffer1 = Alarmminute - t_minute;
        }
      
      }else{ // for minute alarms

      Alarmsecond = 0; byteBuffer2 = 0;  
      if(t_second>58){Alarmminute = Alarmminute + 1;} 
      // and extra buffer if we are too close to rollover
         
      do{ 
        Alarmminute = Alarmminute + 1;
        }while(Alarmminute % SampleIntervalMinutes); // all non-zero results considered true // forces alignment
      byteBuffer1 = Alarmminute-t_minute;
      }

      Serial.print(F("Start-up Sync Delay: "));
      if(SampleIntervalMinutes>0){Serial.print(byteBuffer1);Serial.print(F("min"));}
      if(SampleIntervalSeconds>0){Serial.print(byteBuffer2);Serial.print(F("sec"));}
      Serial.println();Serial.flush();
  
  if (Alarmminute > 59 ){ Alarmhour = Alarmhour+1; Alarmminute = 0;}  // alt Alarmminute = SampleIntervalMinutes? for longer delay if started at rollover
  if (Alarmhour > 23)   { Alarmday = Alarmday+1; Alarmhour = 0;}      // but day not used here

  // NOW set the 1st -ALIGNED- wakeup alarm:
  AlarmSelectBits = 0b00001100;             // A1 Alarm when minutes AND seconds match, ignores days, hours
  RTC_DS3231_setA1Time(0, 0, Alarmminute, Alarmsecond, AlarmSelectBits, 0, 0, 0);
  RTC_DS3231_turnOnAlarm(1);                // alarm will break the logger out of flashing RED&BLUE light sync delay that follows
  noInterrupts ();                          // make sure we don't get interrupted before we sleep
  bitSet(EIFR,INTF0);                       // clear any previous flags for interrupt 0 (D2) see https://gammon.com.au/interrupts
  rtc_INT0_Flag=false;                      // Flag gets set TRUE only inside rtc_d2_alarm_ISR ISR
  attachInterrupt(0,rtc_d2_alarm_ISR, LOW); // RTC SQW alarms LOW and is connected to pin D2 which is interupt channel 0
  interrupts ();
//---------------------------------------------------------------------------------------------- 
// calculate and save UNIXtime for the wakup alarm we just set // same calculation used in function: RTC_DS3231_unixtime():
// we are doing it here because UART is still connected to supply power for the internal eeprom saving which draws alot of current (8mA for EEprom + 5mA for ProMini)
  uint16_Buffer = rtc_date2days(t_year, t_month, Alarmday); // the days calculation     // don't start your logger at the midnight rollover!
  uint32_Buffer = rtc_time2long(uint16_Buffer, Alarmhour, Alarmminute, Alarmsecond); // convert that to seconds
  uint32_Buffer += 946684800;               // this will be the unixtime when we wake AFTER the sync delay is over // add # seconds from 1970 to 2000 = delta between Unixtime start & our RTC's internal start time
  EEPROM.put(0,uint32_Buffer);              // store loggerStartTime so it can be used reconstructing each records timestamp in the startMenu_sendData2Serial() later during download

  #ifdef PIRtriggersReadings_4byte
    previousPIRtriggerTime = uint32_Buffer;
  #endif

 
//------------------------------------------------------------------------------  
  Serial.println(F("Bl&Gr LEDs 'flicker' for SyncDelay til 1stRead, then GREEN pips @sample time"));  
  Serial.println(F("--- If you don't observe the 'flicker' then restart the logger again! ---"));
  if(!ECHO_TO_SERIAL){          // if it's not being used, shut down the UART peripheral now to save power
    Serial.println(F("Disconnect UART now - NO additional messages will be sent over serial.")); Serial.flush();
        // power_usart0_disable();          // we waited until this point because the startup input menu requires serial input via the UART
        // NOTE: TOO many students were forgetting to wrap the Serial.print statements in the main loop with if(ECHO_TO_SERIAL){ } so we commented usart0_disable out
                                            // digital pins 0(RX) and 1(TX) are connected to the UART peripheral inside the 328p chip
                                            // Connecting anything to these pins may interfere with serial communication, including causing failed uploads
      }
   Serial.flush();
//------------------------------------------------------------------------------
// FIRST sampling wakeup alarm is already set But instead of simply going to sleep we will use LowPower.powerDown SLEEP_30MS
// to wake the logger  and toggle the LEDs ON/Off so user can tell we are in the sync-delay period before logging starts
// GREEN & BLUE leds start in opposite states so they ALTERNATE when toggled by the PIN register

  turnOnGreenLED(); 
  do{   toggleBlueAndGreenLEDs(); 
        LowPower.powerDown(SLEEP_30MS, ADC_OFF, BOD_OFF);
        }while(!rtc_INT0_Flag);                 // sends you back to do{ unless the RTC alarm has triggered
  
  RTC_DS3231_ResetBothAlarmFlags();           // writes 0 to the alarm flags A1F and A2F in the STATUS_REG  but does not disable the next alarm       
  // Note: detachInterrupt(0); already done inside the rtc_d2_alarm_ISR 
  rtc_INT0_Flag=false; 
  turnOffAllindicatorLEDs();  //terminates synchronization time delay -we are now ready to start logging!

//terminates synchronization time delay -we are now ready to start logging!
//------------------------------------------------------------------------------------------------------------

  #ifdef PIRtriggersReadings_4byte
    // PIRtriggers is a special case were we don't want any RTC alarms to occur
    // so we set the alarm register to a time that can not happen
    // PIRtriggers also skips the normal Alarm set procedure at the begining of the main loop
    RTC_DS3231_setA1Time(0,0,62,0,0b00001100,0,0,0);              // DISABLE AL1 by setting to an INVALID TIME that can never be reached: 61 for minutes
                                                                  // 0b00001100 = A1 Alarm when minutes AND seconds match, ignores days, hours
    LowPower.powerDown(SLEEP_15MS, ADC_OFF, BOD_OFF);             // give the RTC memory register some WRITING time 
  #endif
  
  #ifndef logCurrentBattery_2byte
    LowestBattery = readRailVoltage();         //sets starting value for LowBat, but only needed if not logging CurrentBat
  #endif

  #ifdef logFreeVariableMemory_2byte              
    freeVariableMemory = freeRam();
  #endif

  Wire.setClock(400000L);  //I2C bus speed = 400 kHz
  // You can speed up the I2C bus speed to 400 kHz for RTC comms (and most sensors)
  // However you must slow the clock down to 100khz when working with the 4k eeprom
                        
}     // terminator for void setup()
//==========================================================================================

//==========================================================================================
//==========================================================================================
//==========================================================================================
//==========================================================================================
//==========================================================================================
//==========================================================================================
//========================== START OF MAIN loop()===========================================
//==========================================================================================
//==========================================================================================
//================================================== START OF MAIN loop()===================
//==========================================================================================
//==========================================================================================
//==========================================================================================
//==========================================================================================
//==========================================================================================
//==========================================================================================

void loop(){

//----------------------------------------------------------------------------------
// HEARTBEAT LED pip by leaving LED on during sleep delays in next RTC Alarm setting
//----------------------------------------------------------------------------------
turnOffAllindicatorLEDs();  // draws about 50uA per LED channel with internal pullup resistors

//------------------------------------------------------------------------------- 
//  *  *  *  *  Set the next RTC wakeup alarm  *  *  *  *  *  *
//-------------------------------------------------------------------------------    
  RTC_DS3231_getTime();                     // populates global t_minute,t_second variables

#ifdef PIRtriggersReadings_4byte
  currentPIRtriggerTime = RTC_DS3231_unixtime();  // special case where we preload a variable for a delta calculation
  d3_INT1_elapsedSeconds = currentPIRtriggerTime - previousPIRtriggerTime;
  previousPIRtriggerTime = currentPIRtriggerTime;
#else
    
  if (SampleIntervalSeconds > 0){           // then our alarm is in (SampleInterval) seconds
      Alarmsecond = (t_second + SampleIntervalSeconds) %60;      // gives seconds from 0-59 sec e.g. 50s+15 = 65s  65%60 = 5s
                                                                 // if (Alarmsecond < SampleIntervalSeconds){Alarmsecond=0;} // would force alignment at first minute rollover
      Alarmminute = 0;
      AlarmSelectBits = 0b00001110;         // A1 Alarm when seconds match, ignores others
        
        //if (SampleIntervalSeconds == 1){  // A1 Alarm once per second = Special case
        //  Alarmminute = 0;
        //  AlarmSelectBits = 0b00001111;   // A1 Alarm once per second = Special case
        //}
      RTC_DS3231_setA1Time(0, 0, 0, Alarmsecond, AlarmSelectBits, 0, 0, 0);     
    } else {                                // use SampleIntervalMinutes
      Alarmsecond = 0;                      // forces matching on even min
      Alarmminute = (t_minute + SampleIntervalMinutes) % 60;    // gives from 0-59
                                            // if (Alarmminute< SampleIntervalMinutes){Alarmminute=0;} // would force alignment at first hour rollover
      AlarmSelectBits = 0b00001100;         // A1 Alarm when minutes and seconds match, ignore days, hours
      RTC_DS3231_setA1Time(0, 0, Alarmminute, Alarmsecond, AlarmSelectBits, 0, 0, 0);
    }

    turnOnGreenAndBlueLED();
      LowPower.powerDown(SLEEP_30MS, ADC_OFF, BOD_OFF);  // RTC memory register WRITING time & battery recovery time
    turnOnGreenLED();
     
    // RTC_DS3231_turnOnAlarm(1); // sets both INTCN & A1IE bits of control register
    // however this only needs to be done once in setup and alarm 1 will always fire, so we don't need to call it here again!
    // All we need do in sleepNwait is clear the stat register A2F,A1F flags 

#endif //terminates #ifdef PIRtriggersReadings_4byte    
 
  if(ECHO_TO_SERIAL){
      Serial.println();Serial.println();
        #ifdef PIRtriggersReadings_4byte
          Serial.print(F(">PIR wakeup #")); Serial.print(d3_INT1_eventCounter);Serial.print(F(": "));
        #else
          Serial.print(F(">Wake: "));
        #endif
      Serial.print(t_year,DEC);Serial.print(F("/"));Serial.print(t_month,DEC);Serial.print(F("/"));Serial.print(t_day,DEC);
      Serial.print(F(" "));Serial.print(t_hour,DEC);Serial.print(F(":"));Serial.print(t_minute,DEC);Serial.print(F(":"));Serial.print(t_second,DEC);

        #ifndef PIRtriggersReadings_4byte
          Serial.print(F(" Next Alarm Set in: "));
          if (SampleIntervalSeconds > 0){ Serial.print(SampleIntervalSeconds); Serial.print(F("sec")); 
          }else{ Serial.print(SampleIntervalMinutes);Serial.print(F("min")); }
        #endif //#ifndef PIRtriggersReadings_4byte
      Serial.println();Serial.flush();
    }
 
  #ifdef logRTC_Temperature_1byte
    rtc_TEMP_degCx4 = RTC_DS3231_getTemp();
      if(ECHO_TO_SERIAL){
        Serial.print(F("RTC[°C]: "));floatBuffer=rtc_TEMP_degCx4/4.0;Serial.print(floatBuffer,2);
      } 
  #endif
    LowPower.powerDown(SLEEP_15MS, ADC_OFF, BOD_OFF);
    turnOffAllindicatorLEDs();
//--------END of RTC activity-----------------
 
#ifdef logCurrentBattery_2byte                              // ADC reads use significant power - only read CurrentBat if saving the data
    CurrentBattery = readRailVoltage();                   // Note: a SLEEP_15MS is embedded in the readRailVoltage function, processor draws about 1mA in sleep mode ADC
    if(ECHO_TO_SERIAL){
        Serial.print(F(", Current Bat[mV]:"));Serial.print(CurrentBattery);Serial.flush();
        }
#endif

#ifdef logFreeVariableMemory_2byte
    freeVariableMemory = freeRam();                   
    if(ECHO_TO_SERIAL){
        Serial.print(F(", VarMem(bytes):"));Serial.print(freeVariableMemory);Serial.flush();
        }
#endif

#ifdef logLowestBattery_1byte
      if(ECHO_TO_SERIAL){ 
      Serial.print(F(", LowBat[mV]:"));Serial.print(LowestBattery);Serial.flush();
      }
 #endif

  // if you are only logging LowestBattery, it might be useful to record the unloaded battery voltage once per day (?)
  //if(t_hour==0 && t_minute==0 && t_second==0){          // midnight reset prevents 'occasional' low readings from permanently resetting the lobat record
  //  LowestBattery = readRailVoltage();                      // no-load readRailVoltage() calls are usually 20-100mv higher than Lobat reads during high drain EEsave events
  //  LowPower.powerDown(SLEEP_15MS, ADC_OFF, BOD_OFF);
  //  }

//+++++++++++++++++++++++++++++++++++++++++++++++++++++++++++++++++++++++++++++++   
//+++++++++++++++++++++++++++++++++++++++++++++++++++++++++++++++++++++++++++++++
// STEP4 : READ your sensors here
//+++++++++++++++++++++++++++++++++++++++++++++++++++++++++++++++++++++++++++++++   
//+++++++++++++++++++++++++++++++++++++++++++++++++++++++++++++++++++++++++++++++

#if defined(readD9resistorwD6ref_2byte) || defined(readD7resistorwD6ref_2byte)
//------------------------------------------------------
  if(ECHO_TO_SERIAL){ Serial.println();Serial.flush();}
  LowPower.powerDown(SLEEP_15MS, ADC_OFF, BOD_OFF);
  ConditionCapacitorOnD8();                             // ConditionCapacitor only needs to be called ONCE before other ICU resistor readings
  //uint32_Buffer = ReadD8riseTimeOnD8();               // charge cycles the cap through D8 to standardize condition // AND it sets all pins with resistor/sensors connected to that common capacitor to input
  uint32_Buffer = ReadD6riseTimeOnD8();                 // loads elapsedTime for 10k ohm resistor
#endif

#ifdef readD7resistorwD6ref_2byte
//-------------------------------
  D7resistor_NewReading = ReadD7riseTimeOnD8();                // a complex function at the end of this program
  D7resistor_NewReading = (referenceResistorValue * D7resistor_NewReading) / uint32_Buffer;
  if(ECHO_TO_SERIAL){
    Serial.print(F(", D7r[Ω]:"));Serial.print(D7resistor_NewReading);Serial.flush();
    }  
#endif

#ifdef readD9resistorwD6ref_2byte   
//-------------------------------
  //alternate wiring: D9resistor_NewReading = ReadD6riseTimeOnD8();
  D9resistor_NewReading = ReadD9riseTimeOnD8();
  D9resistor_NewReading = (referenceResistorValue * D9resistor_NewReading) / uint32_Buffer;
      if(ECHO_TO_SERIAL){
        Serial.print(F(", D9r[Ω]:"));Serial.print(D9resistor_NewReading);Serial.flush();
      }  
#endif

#ifdef readBh1750_LUX_2byte
//-------------------
  bh1750.start(BH1750_QUALITY_LOW, BH1750_MTREG_LOW);   // triggers a new sensor reading
                                                        // LOW MTreg:31  resolution lux:7.4, 121557 is highest lux
  LowPower.powerDown(SLEEP_30MS, ADC_OFF, BOD_OFF);;      // L-Resolution Mode Measurement Time 16-24 msec                   
  //LowPower.powerDown(SLEEP_30MS, ADC_ON, BOD_OFF);    // H-Resolution Mode Measurement Time is much longer: 120-180 ms

  lux_BH1750_RawInt =bh1750.getRaw();                   // reading can reach 120,000
  LowPower.powerDown(SLEEP_30MS, ADC_OFF, BOD_OFF);;      // battery recovery after I2C - not really needed with this low current sensor
    
  if(ECHO_TO_SERIAL){  
      Serial.println();Serial.print(F(", Bh1750(rawInt): "));Serial.print(lux_BH1750_RawInt);
      Serial.print(F(", Lux(calc): "));Serial.print(bh1750.calcLux(lux_BH1750_RawInt,BH1750_QUALITY_LOW,BH1750_MTREG_LOW),2);Serial.flush();
      //if you call calcLux() without Quality & MTreg, the parameters from the last measurement are used for the calculation
    }
#endif //readBh1750_LUX_2byte

//read Sht3x RH sensor
#if defined(readSht3x_Temp_2byte) || defined(readSht3x_Humidity_2byte)
//---------------------------------------------------------------
  sht3x.requestData();
  LowPower.powerDown(SLEEP_30MS, ADC_OFF, BOD_OFF); //15.5ms listed max in datasheet
  //do{ booleanBuffer = sht3x.dataReady(); }while(!booleanBuffer);
  //dataReady check uses excessive amount of power
  sht3x.readData();
  #endif
  
#ifdef readSht3x_Humidity_2byte
  //Sht3x_RH_RawInt= getRawHumidity();  //raw two-byte representation of humidity directly from the sensor
  //Sht3x_RH_percent = Sht3x_RH_RawInt * (100.0 / 65535);
  Sht3x_RH_percent = sht3x.getHumidity();
  if(ECHO_TO_SERIAL){
    Serial.print(F(", Sht3x RH: ")); Serial.print(Sht3x_RH_percent,2); Serial.print(F(" %")); }
  #endif
  
#ifdef readSht3x_Temp_2byte 
  //Sht3x_Temp_RawInt = getRawTemperature(); //raw two-byte representation of temperature directly from the sensor
  //Sht3x_Temp_degC = Sht3x_Temp_RawInt * (175.0 / 65535) - 45;
  Sht3x_Temp_degC = sht3x.getTemperature();
  if(ECHO_TO_SERIAL){
    Serial.print(F(", Sht3x Temp: ")); Serial.print(Sht3x_Temp_degC,2); Serial.print(F(" °C")); }
  #endif

#if defined(readSht3x_Temp_2byte) || defined(readSht3x_Humidity_2byte)
    if(ECHO_TO_SERIAL){Serial.println();Serial.flush();}
  #endif

// read bmp280 sensor
//-------------------
#if defined(readBMP280_Temp_2byte) || defined(readBMP280_Pressure_2byte) || defined(recordBMP280_Altitude_2byte) //  '||' means 'OR'
  bmp280.startForcedConversion(); 
  LowPower.powerDown(SLEEP_30MS, ADC_OFF, BOD_OFF);; //NOTE: sleep time needed here depends on your oversampling settings
  if(ECHO_TO_SERIAL){ Serial.println();}
  #endif

#ifdef readBMP280_Temp_2byte
  bmp280.getCurrentTemperature(Bmp280_Temp_degC);
  LowPower.powerDown(SLEEP_15MS, ADC_OFF, BOD_OFF);
  if(ECHO_TO_SERIAL){ Serial.print(F(", b280 Temp: ")); Serial.print(Bmp280_Temp_degC,2); Serial.print(F(" °C")); }
#endif

#ifdef readBMP280_Pressure_2byte
  bmp280.getCurrentPressure(Bmp280_Pr_mBar);
  LowPower.powerDown(SLEEP_15MS, ADC_OFF, BOD_OFF);
  if(ECHO_TO_SERIAL){ Serial.print(F(", b280 Pr. "));Serial.print(Bmp280_Pr_mBar,2); Serial.print(F(" hPa")); }
#endif

#ifdef recordBMP280_Altitude_2byte
  bmp280.getCurrentAltitude(Bmp280_altitude_m);
  if(ECHO_TO_SERIAL){ Serial.print(F(", b280 Alt. ")); Serial.print(Bmp280_altitude_m,2); Serial.print(F(" m,")); }
#endif
// to read all three at the same time: bmp280.getCurrentMeasurements(Bmp280_Temp_degC, Bmp280_Pr_mBar, Bmp280_altitude_m); //function returns 1 if readings OK
#if defined(readBMP280_Temp_2byte) || defined(readBMP280_Pressure_2byte) || defined(recordBMP280_Altitude_2byte) //  '||' means 'OR'
  if(ECHO_TO_SERIAL){ Serial.flush();}
#endif

// read BME280 sensor
//-------------------
#if defined(recordBMEtemp_2byteInt) || defined(recordBMEpressure_2byteInt) || defined(recordBMEhumidity_2byteInt)
   climateSensor.takeForcedMeasurement();
   LowPower.powerDown(SLEEP_30MS, ADC_OFF, BOD_OFF);;//At lowest resoluton this should be plenty of time 
   #if defined(recordBMEtemp_2byteInt)
    Bmx_temperature = climateSensor.getTemperatureCelsius();
    if(ECHO_TO_SERIAL){Serial.print(F(" BmeT: "));Serial.print(Bmx_temperature/100);Serial.print(F("."));Serial.print(Bmx_temperature%100);Serial.print(F("°C"));}
   #endif
   #if defined(recordBMEpressure_2byteInt)
    Bmx_pressure = climateSensor.getPressure();
    if(ECHO_TO_SERIAL){Serial.print(F(" BmePr: "));Serial.print(Bmx_pressure/100);Serial.print(F("."));Serial.print(Bmx_pressure%100);Serial.print(F("hPa"));}
   #endif
   #if defined(recordBMEhumidity_2byteInt)
    Bme_humidity = climateSensor.getRelativeHumidity();
    if(ECHO_TO_SERIAL){Serial.print(F(" BmeRh: "));Serial.print(Bme_humidity/100);Serial.print(F("."));Serial.print(Bme_humidity%100);Serial.print(F("%"));}
   #endif
    if(ECHO_TO_SERIAL){Serial.println();Serial.flush();}
#endif

#ifdef readSi7051_Temp_2byte
//------------------------------------------------------------------------------
    TEMP_si7051 = readSI7051();                       // see functions at end of this program
        if(ECHO_TO_SERIAL){ 
          Serial.print(F(", SI7051 temp: "));Serial.print(((175.26*TEMP_si7051)/65536.0)-46.85 ,3);Serial.flush();//print 3 decimals
          }
    LowPower.powerDown(SLEEP_30MS, ADC_OFF, BOD_OFF);;  //  battery recovery time
#endif

#ifdef PIRcountPerInterval_2byte
    if(ECHO_TO_SERIAL){ Serial.print(F(" ,PIR total:")); Serial.print(d3_INT1_eventCounter);Serial.flush();}
#endif
//-----------------------------------------------------
// Sensor readings finished: turn off the indicator LED 
//-----------------------------------------------------
turnOffAllindicatorLEDs();

//---------------------------------------------------------------------------------
// Setup ADC to read the rail voltage DURING the EEprom data save:
//---------------------------------------------------------------------------------
 
    //bitSet(ACSR,ACD); //disable analog comparator already done in setup
    SPCR = 0; ADCSRA =0; power_all_disable();
    power_timer0_enable(); 
    power_twi_enable(); 
    power_adc_enable();
    ADMUX = set_ADMUX_2readRailVoltage; ADCSRA = set_ADCSRA_2readRailVoltage;
//bitWrite(ADCSRA,ADPS2,1);bitWrite(ADCSRA,ADPS1,1);bitWrite(ADCSRA,ADPS0,0);   // 64 (default) prescalar @ 8MHz/64 = 125 kHz, =~104uS/ADC reading
    bitSet(ADCSRA,ADSC);       // triggers a 1st throw-away ADC reading to engauge the Aref cap //1st read takes 20 ADC clock cycles instead of usual 13  
    bitClear(DDRB,5);bitSet(PORTB,5);  // pip the RED d13 LED with INPUT_PULLUP to indicate EEprom save event
    LowPower.powerDown(SLEEP_15MS, ADC_ON, BOD_OFF); // NOTE: Aref cap settling only needs ~5 milliseconds
    bitClear(PORTB,5);                // D13 red LED: pullup OFF

  // NOTE: Aref capacitor Rise time can take 5milliseconds after starting ADC so 15ms of ADC_ON powerDown sleep works 

//---------------------------------------------------------------------------------
//  SAVE NEW SENSOR READINGS into EEprom & READ battery after
//---------------------------------------------------------------------------------
// the number of bytes you transfer here must match the number in sensorBytesPerRecord
// AND bytes written to per cycle MUST divide evenly into the eeproms pagesize
// So each cycle can only add 1,2,4,8 or 16 bytes - not 3 , not 5, not 7 etc. 
// or you bork the 'powers of 2' math required by page boundaries in the EEprom
//---------------------------------------------------------------------------------
//  the general pattern when sending bytes to store in an I2C eeprom:

//  Wire.beginTransmission(EEpromAddressonI2Cbus);  // first byte in I2C buffer
//  Wire.write(highByte(memoryAddress));            // MSB is second byte
//  Wire.write(lowByte(memoryAddress));             // LSB is third byte
//    Wire.write(byte);                             // adds 1st byte of SAVED data to buffer
//    Wire.write(byte);                             // adds 2nd byte of SAVED data to buffer
//   -more wire.writes-                             // CONTINUE adding up to 16 DATA bytes per record - divide the sensor variables up into individual bytes for sending
//  Wire.endTransmission();                         // Only when this command executes does the I2C memory buffer get sent over the I2C bus

  // beginTransmission() and write() are slightly misleading terms, they do NOT send commands/packets to the I2C device. 
  // They are simply queuing commands, which means they are adding bytes to an internal buffer in the Wire/TWI library. 
  // This internal buffer is not sent to the I2C device on the bus until end.Transmission() is called 
  // estimate about 100us per byte at 100khz bus = 0.7milliseconds for 3(adr)+4(payload) bytes
//---------------------------------------------------------------------------------

  if(totalBytesOfStorage==4096){
  Wire.setClock(100000UL); // Set I2C bus speed to 100 kHz
  //when working with the default 4K eeprom on the RTC module
  //NOTE: larger eeproms and most other I2c devices work just fine at 400khz
  //but if your wires get too long you may have to slow the bus
  //for them too.
  }

//---------------------------------------------------------------------------------
  Wire.beginTransmission(EEpromI2Caddr);            // STARTS filling the I2C transmission buffer with the eeprom I2C bus address
  Wire.write(highByte(EEmemPointer));             // send the HighByte of the EEprom memory location we want to write to
  Wire.write(lowByte(EEmemPointer));              // send the LowByte of the EEprom memory location   // Note: we add  'bytes per record' to EEmemPointer at the end of the main loop  
//---------------------------------------------------------------------------------
// NOW load the sensor variables - one byte at a time - into the I2C transmission buffer with Wire.write statements
// ORDER of loading here MUST EXACTLY MATCH the order of the bytes retrieved in the startMenu_sendData2Serial function
// ALSO NOTE we are using 3x 0xFF as our END OF FILE marker to stop the download (Erased eeproms typically have all bits set to 1)
// So we must implement various 'traps' to prevent 3 successive 0xFF's from being saved in the data

#ifdef PIRtriggersReadings_4byte  
  uint32_Buffer = RTC_DS3231_unixtime(); // must call this function AFTER calling RTC_DS3231_getTime to updates the global t_ variables
  
  // how to slice a 4-byte LONG uint32_t into individual bytes:  & 0b11111111 extracts only the lowest eight bits
  loByte = uint32_Buffer & 0b11111111;  
  uint32_Buffer = uint32_Buffer>>8; 
  byteBuffer1 = uint32_Buffer & 0b11111111;
  uint32_Buffer = uint32_Buffer>>8; 
  byteBuffer2 = uint32_Buffer & 0b11111111;
  uint32_Buffer = uint32_Buffer>>8;
  hiByte = uint32_Buffer & 0b11111111;      
    Wire.write(hiByte);       // the highest byte
    Wire.write(byteBuffer2);  // next to highest byte
    Wire.write(byteBuffer1);  // next to lowest byte
    Wire.write(loByte);       // byte 1 (the lowest byte)      
#endif

#ifdef logLowestBattery_1byte                     // INDEX compression converts lowBattery reading to # less than 255 which can be stored in one byte eeprom memory location
//-------------------------------------------------------------------------------------------------------
  int16_Buffer = (LowestBattery-1700)/16;         // index compression looses some data due to rounding error  - so record is reduced to only 16mv/bit resolution
  byteBuffer1 = lowByte(int16_Buffer);
  if(byteBuffer1==255){byteBuffer1=254;}          // Trapping 0xFF to preserve End of Data check in startMenu_sendOPDreadings2Serial
        Wire.write(byteBuffer1);                  // write that single compressed byte to eeprom (we will have to expand it back later !) 
#endif //logLowestBattery_1byte

#ifdef logRTC_Temperature_1byte                   // NOTE: this 1-byte COMPRESSED encoding limits our temperature range to 0-63 degrees 
//--------------------------------------------------------------------------------------------------------
  int16_Buffer = rtc_TEMP_degCx4 + RTC_TempRangeOffset; // add 8*10 shifts the 4xInt 63 degree range by 20C, so we can record -20C to +43C with no loss of information because the resolution is only 0.25C              
  if(int16_Buffer>254){int16_Buffer=254;}         // ONLY THE FIRST data byte saved in each record must have a ZERO TRAP to preserve zero EOF indicators in EEprom
  if(int16_Buffer<0){int16_Buffer=0;}
  byteBuffer1 = lowByte(int16_Buffer);
    Wire.write(byteBuffer1); 
#endif //logRTC_Temperature_1byte

//+++++++++++++++++++++++++++++++++++++++++++++++++++++++++++++++++++++++++++++++
//+++++++++++++++++++++++++++++++++++++++++++++++++++++++++++++++++++++++++++++++
// STEP5 : add more sensor data bytes to the I2C buffer HERE as required ++++++++
//+++++++++++++++++++++++++++++++++++++++++++++++++++++++++++++++++++++++++++++++
//+++++++++++++++++++++++++++++++++++++++++++++++++++++++++++++++++++++++++++++++
// Note: better overflow catching could be added here - but leaving as a student exercise

#ifdef PIRcountPerInterval_2byte
  d3_INT1_eventCounter = d3_INT1_eventCounter+1;       // we 'add one' so that the 1st stored byte is never zero - even when the count actually is zero- this is our zero trap
  loByte = lowByte(d3_INT1_eventCounter);
    Wire.write(loByte);
  hiByte = highByte(d3_INT1_eventCounter);
    Wire.write(hiByte);
  d3_INT1_eventCounter = 0;                            // after saving the data we can reset our event counter to zero
#endif

#ifdef readD7resistorwD8pullup_2byte
//---------------------------------
// D7resistor_NewReading changed to 4-byte uint32 to avoid calculation overflows
// but we only record the lowest two of those bytes here
// this requires bitmath extraction of high & low bytes for eeprom storage
  uint32_Buffer = D7resistor_NewReading; 
    if (uint32_Buffer>65534){uint32_Buffer=65534;}    // Prevents uint16_t Overflow & Traps 0xFF
  byteBuffer1   = uint32_Buffer & 0b11111111;         // lobyte
    Wire.write(byteBuffer1); 
  uint32_Buffer = uint32_Buffer>>8;
  byteBuffer2   = uint32_Buffer & 0b11111111;         // highByte
    Wire.write(byteBuffer2);
#endif // #ifdef readNTC_D6refD7ntc

#ifdef readD6ResistorwD8pullup_2byte
//------------------------------
// D6resistor_NewReading changed to 4-byte uint32 to avoid calculation overflows
// this requires bitmath extraction of high & low bytes for eeprom storage
  uint32_Buffer = D6resistor_NewReading; 
    if (uint32_Buffer>65534){uint32_Buffer=65534;}    // Prevents uint16_t Overflow  // & Trapping 0xFF
  byteBuffer1   = uint32_Buffer & 0b11111111; //lobyte
    Wire.write(byteBuffer1); 
  uint32_Buffer = uint32_Buffer>>8;
  byteBuffer2   = uint32_Buffer & 0b11111111; //highByte
    Wire.write(byteBuffer2);
#endif // #ifdef readD6ResistorwD8pullup_2byte

#ifdef readBh1750_LUX_2byte
//-------------------------
  if (lux_BH1750_RawInt==65535){lux_BH1750_RawInt=65534;}  // Trap 0xFF to preserve EOF check in startMenu_sendOPDreadings2Serial
  loByte = lowByte(lux_BH1750_RawInt);
        Wire.write(loByte);
  hiByte = highByte(lux_BH1750_RawInt);
        Wire.write(hiByte);  
#endif // #ifdef readBh1750_LUX_2byte

#ifdef readSht3x_Humidity_2byte
  //Sht30 resolution is only: 0.01°C and 0.01 %RH so only need two decimal places
  Sht3x_RH_percent = Sht3x_RH_percent*100.00;   // convert float reading to integer preserving two decimal places
  int16_Buffer = (int16_t)Sht3x_RH_percent;  
  loByte = lowByte(int16_Buffer);               // first byte of record gets checked by 
        Wire.write(loByte);
  hiByte = highByte(int16_Buffer);
        Wire.write(hiByte);  
#endif

#ifdef readSht3x_Temp_2byte                    // Sht30 resolution is only: 0.01°C and 0.01%RH
  Sht3x_Temp_degC = Sht3x_Temp_degC*100.00;     // convert float reading to integer preserving two decimal places
  int16_Buffer = (int16_t)Sht3x_Temp_degC;  
  loByte = lowByte(int16_Buffer);               // first byte of record gets checked by 
        Wire.write(loByte);
  hiByte = highByte(int16_Buffer);
        Wire.write(hiByte); 
#endif

#ifdef readBMP280_Temp_2byte
  Bmp280_Temp_degC = Bmp280_Temp_degC*100.00;   //convert float reading to integer preserving two decimal places
  int16_Buffer = (int16_t)Bmp280_Temp_degC;  
  loByte = lowByte(int16_Buffer);               // first byte of record gets checked by 
        Wire.write(loByte);
  hiByte = highByte(int16_Buffer);
        Wire.write(hiByte);  
#endif

#ifdef readBMP280_Pressure_2byte
  Bmp280_Pr_mBar = Bmp280_Pr_mBar*10.0;         //convert float reading to integer preserving ONE decimal place
  int16_Buffer = (int16_t)Bmp280_Pr_mBar;  
  loByte = lowByte(int16_Buffer);              // first byte of record gets checked by 
        Wire.write(loByte);
  hiByte = highByte(int16_Buffer);
        Wire.write(hiByte);     
#endif

#ifdef recordBMP280_Altitude_2byte
  Bmp280_altitude_m = Bmp280_altitude_m*100.00;     //convert float reading to integer preserving two decimal places
  int16_Buffer = (int16_t)Bmp280_altitude_m;   // Note: *100 overuns the int at higher altitudes - switch to *10
  loByte = lowByte(int16_Buffer);              // first byte of record gets checked by 
        Wire.write(loByte);
  hiByte = highByte(int16_Buffer);
        Wire.write(hiByte);  
#endif

#ifdef recordBMEtemp_2byteInt            // stored in int32_t Bmx_temperature with 2 decimals 'embedded' in the integer
//---------------------------
  int16_Buffer = Bmx_temperature;        // room in int16 to ±32,000 so no danger of overflow
  loByte = lowByte(int16_Buffer); 
      Wire.write(loByte);
  hiByte = highByte(int16_Buffer);
      Wire.write(hiByte);
#endif

#ifdef recordBMEpressure_2byteInt        // stored in int32_t Bmx_pressure with 2 decimals 'embedded' in the integer
//-------------------------------
  uint16_Buffer = Bmx_pressure - 80000;  // -80000 for SCALING to fit into uint16 with two preserved decimal places
  if(uint16_Buffer==65535){uint16_Buffer=65534;} // Traps 0xFF to preserve EOF check in startMenu_sendOPDreadings2Seriall
  loByte = lowByte(uint16_Buffer); 
      Wire.write(loByte);
  hiByte = highByte(uint16_Buffer);
      Wire.write(hiByte);
#endif

#ifdef recordBMEhumidity_2byteInt       // stored in int32_t Bme_humidity with 3 decimals 'embedded' in the integer
//-------------------------------
  uint16_Buffer = Bme_humidity;
  if(uint16_Buffer==65535){uint16_Buffer=65534;}
  loByte = lowByte(uint16_Buffer); 
      Wire.write(loByte);
  hiByte = highByte(uint16_Buffer);
      Wire.write(hiByte);
#endif

#ifdef logCurrentBattery_2byte                      // stores the 'raw' 16-byte integer using two bytes (ie with no compression)
//-----------------------------------------------------------------------------------------------------------------------
  uint16_Buffer = CurrentBattery;
  if(uint16_Buffer==65535){uint16_Buffer=65534;}
  loByte = lowByte(uint16_Buffer);           // note: we save the low byte first because it is almost never zero
        Wire.write(loByte);                   // first byte added to I2C buffer
  hiByte = highByte(uint16_Buffer);
        Wire.write(hiByte);                   // 2nd byte of data added to I2C buffer 
#endif //logCurrentBattery_2byte

#ifdef logFreeVariableMemory_2byte             // stores the 'raw' 16-byte integer using two bytes (ie with no compression)
//-----------------------------------------------------------------------------------------------------------------------
  uint16_Buffer = freeVariableMemory;
  if(uint16_Buffer==65535){uint16_Buffer=65534;}
  loByte = lowByte(uint16_Buffer);
        Wire.write(loByte);              
  hiByte = highByte(uint16_Buffer);
        Wire.write(hiByte);  
#endif //logFreeVariableMemory_2byte

#ifdef readSi7051_Temp_2byte                         // stores the 'raw' 16-byte integer using two bytes (ie with no compression)
//-----------------------------------------------------------------------------------------------------------------------
  uint16_Buffer = TEMP_si7051;
  if(uint16_Buffer==65535){uint16_Buffer=65534;}
  loByte = lowByte(uint16_Buffer);              //NOTE TEMP_si7051 overruns uint16_t if >40C!
        Wire.write(loByte);
  hiByte = highByte(uint16_Buffer); 
        Wire.write(hiByte);
#endif //readSi7051_Temp_2byte

//-------------------------------------------------------------------------------
    bitSet(ADCSRA,ADSC); //trigger the next ADC during the I2C send takes .104 msec
    Wire.endTransmission(); // ONLY AT THIS POINT do the bytes accumulated in the buffer actually get sent
    // Wire.endTransmission(); is blocking so the next ADC read happens AFTER the send
//-------------------------------------------------------------------------------
// The EEPROM enters an internally-timed write cycle to memory which takes ~3-10ms [longer for larger eeproms because of page size]
// 4k AT24c32 write draws ~10mA for about 10ms @3mA, but newer eeproms can take only only 5ms @3mA
// the coincell battery experiences a SIGNIFICANT VOLTAGE DROP due to its internal resistance during this load
//-------------------------------------------------------------------------------
 
    // ignore the first ADC reading & take another:
    bitSet(ADCSRA,ADSC); while(bit_is_set(ADCSRA,ADSC)); uint16_Buffer = ADC;
    ADCSRA = 0; power_adc_disable();

// -------------------------------------------------------------------------------
// CRITICAL: EEproms are sensitive to voltage fluctuations during the save and will HANG if you do too much
// WARNING: wrt EEprom Polling (which works!): any I2C exchange draws 3.5mA because cpu is active while EEprom write usually draws 1-1.5mA
// CRITICAL understanding: DO NOT TURN OFF THE I2C bus (or Timer0?) too soon after sending data to EEPROM
// I'm not sure why this is but some EEproms hang if you powerdown right after endTransmission(?)
// Idle mode stops the CPU but keeps peripherals like timers and serial communication active.
// -------------------------------------------------------------------------------

if(totalBytesOfStorage>4096){
    //larger eeproms get a period of IDLE before going to sleep
    //but IDLE is not compatible with the 4k
    noInterrupts();TCNT0=0;interrupts(); // reset timer0 for 1st ovrflow to wake the processor in 2.048 ms [at 8mhz]
      // NOTE: could shorten overflow time to 1msec by preloading TCNT0 = 128;
      // 8,000,000 Hz / 64 = 125,000 Hz // 1 / 125,000 Hz = 0.000008 seconds = 8 µs/tick, // 8 µs/tick * 256 ticks = 2048 µs = 2.048 ms
      // NOTE: 2msec aligns well on scope with transition from erase to write. Also generally a bad idea to mess with Timer0 too much.
    LowPower.idle(SLEEP_15MS, ADC_OFF, TIMER2_OFF, TIMER1_OFF, TIMER0_ON, SPI_OFF, USART0_OFF, TWI_ON);
      // SLEEP_FOREVER works, but WTD on gives us a safety wakeup source if something else locks the cpu?)
      // 1mA IDLE + 1.4mA EEsave current is ~2.5mA - less than full 3.5mA during the I2C data send     
      // _FOREVER works, but leaving WTD on gives us a safety wakeup source & WTD gets reset in the NEXT sleep
    }

    bitClear(DDRB,5);bitSet(PORTB,5);  // pip the RED d13 LED with INPUT_PULLUP to indicate EEprom save event
    LowPower.powerDown(SLEEP_15MS, ADC_OFF, BOD_OFF); // Cr2032 Battery recovery time: & larger eeproms seem to need some recovery time or RTC alarm wont set
    //Waking the 328p from powerdown takes 16,000 clock cycles (~2milliseconds @8MHz +60µS if BOD_OFF) and the ProMini draws ~250µA while waiting for the oscillator to stabilize.
    bitClear(PORTB,5);                // D13 red LED: pullup OFF

  uint16_Buffer=uint16_Buffer+1;// compensates for very short drop spikes observed on 'scope (with 200uF rail caps)
#ifdef logLowestBattery_1byte 
  LowestBattery = InternalReferenceConstant / uint16_Buffer;
  //if logging Lowest (say for NTC calibrations) let low battery get over-written every time it is generated
#else   // we are logging the lowbat only ONCE PER DAY
  CurrentBattery = InternalReferenceConstant / uint16_Buffer;
  if(t_hour==0 && t_minute==0 && t_second==0){  LowestBattery = 5764; }  // midnight reset to high value prevents 'occasional' low battery readings from permanently affecting the battery record                              
  if(CurrentBattery < LowestBattery){ LowestBattery = CurrentBattery;} 
#endif

  if(ECHO_TO_SERIAL){
      power_usart0_enable();
      } 

  if(totalBytesOfStorage==4096){
  Wire.setClock(400000UL); // Set I2C bus speed to 400 kHz
  //now that we are finished working with the 4K eeprom on the RTC module
  //you can speed the bus to 400khz for almost all other I2c devices
  }
  
//+++++++++++++++++++++++++++++++++++++++++++++++++++++++++++++++++++++++++++++++   
//+++++++++++++++++++++++++++++++++++++++++++++++++++++++++++++++++++++++++++++++
// OLED DISPLAY of DATA    [ AFTER alarm set & Data save ]
//+++++++++++++++++++++++++++++++++++++++++++++++++++++++++++++++++++++++++++++++   
//+++++++++++++++++++++++++++++++++++++++++++++++++++++++++++++++++++++++++++++++
    // NOTE: 64x32 screen displays only the CENTER pixels of the1306 controllers  128x64 pixel memory!
    // so first collumn/ pixel on micro oled screen is 32 collums from LEFT of memory space
    // when using the 128x64 driver the first row starts at (32,4), and entire screen occupies 8pixel heigh rows 4-5-6-7
    // 5x7 system font can display 10 characters accross the screen
//------------------------------------------------------------------------------
    // The SSD1306 controller operates at 1.65V to 3.3V but we may need a beefier capacitor for the 
    // OLEDs 1.5mA current draw while cpu is also running?
    // screen off: logger goes to about 4.5uA to sleep, 
    // display on with minimal text: about 900uA (quite jumpy - may need 1000uF cap?)
    // I did notice that with the larger 0.96" screens as well - voltage jumpy till 1000uF rail cap?
    // NOT worth reducing contrast with this small text! Its already hard to see?
    // START a run-duration test with one of these OLED loggers [and repeat test with larger 1kuF capacitor] 
//-------------------------------------------------------------------------------
  // oled.setInvertMode(1); // Toggle invert mode for next line of text.
  // oled.setLetterSpacing(uint8_t pixels) { m_letterSpacing = pixels; } //pixels letter-spacing in pixels before magnification, setFont() will restore default letter-spacing.
  // oled.skipColumns(uint8_t n) { m_skip = n; } //Skip leading pixels writing characters to display / display RAM
  // oled.clearField(col[i%2], rows*(i/2), 4);

#ifdef OLED_64x32_SSD1306   // no need to print the same thing overagain!
                            // the less you print the faster the I2C transaction goes at the start - big power lump
                            // I2C is when both logger & screen are on  - biggest power use
                            // a battery reading is needed during this operatino as it's a huge hit on the coincell??

//noInterrupts();CLKPR=bit(CLKPCE);CLKPR=clock_div_8;interrupts(); //Current draw at 3.3V for the '328P is approximately 1mA for 1 MHz & 3 mA for 8 MHz
// Waking from powerdown now takes 16 milliseconds

// MUST SET the RTC alarm BEFORE adding display screen-time
// AND make sure you don't over-run your alarm interval!

  //You can 'program' the OLED controller with the screen pixels turned off!
  //oled.clear();  //better to use oled.clearField(col[i%2], rows*(i/2), 4); //clear screen blanks entire memory pixel by pixel
  oled.set1X(); // standard font size. //this is clearing the entire memory - can we just clear the display space?
  //oled.skipColumns(32);? to bump us past the first 32 hidden collumns?

  #ifdef logRTC_Temperature_1byte
  //oled.clearField(32,4,10);
  oled.setCursor(32,4); //oled.setCursor(Column, Row) -row is from the upper left corner
  oled.print(F("RTC    temp")); //5x7 system font can display 10 characters accross the screen
  LowPower.powerDown(SLEEP_120MS, ADC_OFF, BOD_ON); //battery recovery after each oled.print statement
  oled.setCursor(32,5); //64x32 screen displays only the CENTER pixels of the 128x64 pixel wide memory!
  // so first collumn/ pixel on micro oled screen from LEFT is at 32 across
  // when using the 128x64 driver the first row starts at (32,4), and entire screen occupies 8pixel heigh rows 4-5-6-7
  oled.print(F("----------")); //5x7 system font can display 10 characters accross the screen
  LowPower.powerDown(SLEEP_120MS, ADC_OFF, BOD_ON);
  oled.set2X();  //2x  5x7 system font can display 5 characters accross the screen
  //oled.clearField(32,6,6);
  oled.setCursor(32,6); //set2X can only start at rows 4 or 5 or 6 (because they take two horizontal rows to display)
  floatBuffer=rtc_TEMP_degCx4/4.0;oled.print(floatBuffer,2);
  oled.print(F(" ")); //blank spaces to clearing the rest of the row
  LowPower.powerDown(SLEEP_120MS, ADC_OFF, BOD_ON);
  #endif

  #ifdef BMP280_Address
  oled.setCursor(32,4); //oled.setCursor(Column, Row) -row is from the upper left corner
  oled.print(F("Pr   mBar")); //5x7 system font can display 10 characters accross the screen
  oled.setCursor(32,5); //64x32 screen displays only the CENTER pixels of the 128x64 pixel wide memory!
  // so first collumn/ pixel on micro oled screen from LEFT is at 32 across
  // when using the 128x64 driver the first row starts at (32,4), and entire screen occupies 8pixel heigh rows 4-5-6-7
  oled.print(F("----------")); //5x7 system font can display 10 characters accross the screen
  oled.set2X();  //2x  5x7 system font can display 5 characters accross the screen
  oled.setCursor(32,6); //set2X can only start at rows 4 or 5 or 6 (because they take two horizontal rows to display)
  oled.print(bmp280_pressure,1);
  LowPower.powerDown(SLEEP_8S, ADC_OFF, BOD_OFF); //the ProMini does not need to stay awake for the screen display time
  oled.clear();oled.set1X(); oled.setCursor(32,4); oled.print(F("Temp   Cel"));
  oled.setCursor(32,5);oled.print(F("----------")); //5x7 font =10 characters accross the screen
  oled.set2X();oled.setCursor(32,6);oled.print(bmp280_temp,2);
  #endif //BMP280_Address

  #ifdef readD7resistorwD6ref_2byte
  oled.setCursor(32,4);oled.print(F("D7r"));
  //oled.setCursor(56,5);oled.print(D7resistor_NewReading);
  
  oled.setCursor(32,5); //64x32 screen displays only the CENTER pixels of the 128x64 pixel wide memory!
  // so first collumn/ pixel on micro oled screen from LEFT is at 32 across
  // when using the 128x64 driver the first row starts at (32,4), and entire screen occupies 8pixel heigh rows 4-5-6-7
  oled.print(F("----------")); //5x7 system font can display 10 characters accross the screen
  oled.set2X();  //2x  5x7 system font can display 5 characters accross the screen
  oled.setCursor(32,6); //set2X can only start at rows 4 or 5 or 6 (because they take two horizontal rows to display)
  oled.print(D7resistor_NewReading);
  #endif //ReadNTC
  
  #ifdef readD9resistorwD6ref_2byte
  oled.setCursor(32,6);oled.print(F("D9r"));
  oled.setCursor(56,7);oled.print(D9resistor_NewReading);
  #endif //ReadLDR

// NOTE OLED is a high drain device with >50msec sustained loads
// so I have wrapped it with a battery level check
  power_adc_enable();   // Aref rise takes ~1msec, while it takes 5msec or more for Aref to fall.
  ADMUX = set_ADMUX_2readRailVoltage; ADCSRA = set_ADCSRA_2readRailVoltage; //sets 2x normal ADC speed
  bitWrite(ADCSRA,ADPS2,1);bitWrite(ADCSRA,ADPS1,1);bitWrite(ADCSRA,ADPS0,0); // 64 (default) prescalar
  bitSet(ADCSRA,ADSC); //while(bit_is_set(ADCSRA,ADSC));// trigger 1st throw-away ADC reading to engauge the Aref capacitor
  //high drain event here // must take more than 3msec for aref cap to stabilize
                              
  oled.ssd1306WriteCmd(SSD1306_DISPLAYON);  // To switch display PIXELS ON // a BIG load on the coincell - 100-200mv drop!

  bitSet(ADCSRA,ADSC);while(bit_is_set(ADCSRA,ADSC)); //throw away read
  bitSet(ADCSRA,ADSC);while(bit_is_set(ADCSRA,ADSC)); //read ADC again
  uint16_Buffer = ADC;  ADCSRA = 0;   power_adc_disable();  // turn off ADC after reading
  uint16_Buffer = InternalReferenceConstant / uint16_Buffer; // convert average ADC reading into railvoltage
  if (uint16_Buffer < LowestBattery) {LowestBattery = uint16_Buffer;}
   
  LowPower.powerDown(SLEEP_8S, ADC_OFF, BOD_OFF);
  oled.ssd1306WriteCmd(SSD1306_DISPLAYOFF); // To switch display OFF

//+++++++++++++++++++++++++++++++++++++++++++++++++++++++++++++++++++++++++++++++  
//+++++++++++++++++++++++++++++++++++++++++++++++++++++++++++++++++++++++++++++++
#endif //end of     OLED display commands
//+++++++++++++++++++++++++++++++++++++++++++++++++++++++++++++++++++++++++++++++   
//+++++++++++++++++++++++++++++++++++++++++++++++++++++++++++++++++++++++++++++++ 

  if (LowestBattery <= systemShutdownVoltage){
      error_shutdown(); // shutdown down the logger
      } 
  
  EEmemPointer = EEmemPointer + sensorBytesPerRecord;   // advances our memory pointer for the next loop
  if( EEmemPointer >= totalBytesOfStorage){             // if eeprom memory is full
      error_shutdown();                                 // shutdown down the logger
      }

#ifdef PIRcountPerInterval_2byte                  // Logger can be woken by D2 AND D3 interrupt events
    rtc_INT0_Flag = false;                              // clear the flag we use to indicate the RTC alarm occurred
    do{                                                 // this do-while locks the processor into a 'counting loop' until the RTC alarm happens.
        sleepNwait4D3InterruptORrtcAlarm();             // counter gets incremented in sleepNwait4D3Interrupt() function //Logger can be woken by D2 AND D3 interrupt events
        if(ECHO_TO_SERIAL){ Serial.println();Serial.println(F(" PIR:")); Serial.print(d3_INT1_eventCounter);Serial.flush();}
      }while (rtc_INT0_Flag == false);                  // if RTC alarm fires Flag becomes true in the ISR & we break out of the PIR do-while counting loop
      
#else
    
    #ifdef PIRtriggersReadings_4byte
    
    // -----------------------------------OPTIONAL-----------------------------
    // Processor waits here with the led lit if the PIR sensor is still sending 'HIGH' signal 
    // - so we can tell if the sensor is being constantly triggered -
     if (digitalRead(3) == HIGH) {              // PIR sensor drives the output pin HIGH when it is detecting motion
        turnOnGreenLED();
          noInterrupts();
            bitSet(EIFR,INTF1);                 // clears the previous int flag inside 328p processor
            attachInterrupt(1,input_d3_interrupt_ISR,LOW);    // Make the processor wait here until the PIR resets
          interrupts ();
        LowPower.powerDown(SLEEP_FOREVER, ADC_OFF, BOD_OFF);
     }  // Once the PIR has reset LOW we enter our normal sleep state
   // -----------------------------------OPTIONAL-----------------------------
   
        sleepNwait4D3InterruptORrtcAlarm();            // Logger wakes ONLY by PIR driven D3 interrupt - because alarm was disabled at end of setup
    #else
        sleepNwait4RTCalarm(); // NORMAL RTC-only sleepNwait with no D3 interrupt-event-counters
    #endif
    
#endif  //PIRcountPerInterval_2byte

//==========================================================================================
//==========================================================================================
   }     // terminator for MAIN loop()======================================================
//==========================================================================================
//==========================================================================================
//==========================================================================================
//==========================================================================================
//==========================================================================================
//==========================================================================================
//==========================================================================================
//==========================================================================================

//==========================================================================================
//   *   *   *   *   *   *   *  Processor SLEEPING functions   *   *   *   *   *   *   *   *
//==========================================================================================
void sleepNwait4RTCalarm() {                          //NOTE all existing pin states are preserved during sleep

  turnOffAllindicatorLEDs();
  pinMode(2,INPUT);                                   //D2 pullup off - not needed with hardware pullups on RTC module

  // FLOAT all pins changed nothing on high 100ua sleepers?
  //for (uint8_t i = 2; i <=13; i++) { 
  //      pinMode(i,INPUT);
  //      }
        
  noInterrupts();
  bitSet(EIFR,INTF0);                                 // clears interrupt 0's flag bit before attachInterrupt(0,isr,xxxx)
  attachInterrupt(0,rtc_d2_alarm_ISR,LOW);            // RTC alarm connected to pin D2 // LOW assures it will always respond if the RTC alarm is asserted
  interrupts();
  LowPower.powerDown(SLEEP_FOREVER, ADC_OFF, BOD_OFF);// ADC_ON simply preserves whatever the current ADC status is (in our case it's already OFF...)
  
  //HERE AFTER WAKING  // note that detachInterrupt(0); happens inside the ISR
    
  Wire.beginTransmission(DS3231_ADDRESS);
  Wire.write(DS3231_STATUS_REG);
  Wire.write(0);                                      // clearing the entire status register turns Off (both) RTC alarms though technically only the last two bits need to be set
  Wire.endTransmission();
  rtc_INT0_Flag = false;                              // clear the flag we use to indicate the RTC alarm occurred  
  bitSet(EIFR,INTF0); bitSet(EIFR,INTF1);            // clear leftover processor interrupt flags - both just in case we have a noise trigger on the other pin
}  //terminator for sleepNwait4RTCalarm

void rtc_d2_alarm_ISR() {                             // this function gets called by attachInterrupt above
  rtc_INT0_Flag = true;                               // this flag only used with interrupt generating sensors on D3
  detachInterrupt(0);                                 // detaching inside the ISR itself makes sure it only triggers ONE time
}

#if defined(PIRcountPerInterval_2byte) || defined(PIRtriggersReadings_4byte)
void sleepNwait4D3InterruptORrtcAlarm(){
  // we need to use two flag variables to keep track of which interrupt woke the logger
  // detachInterrupt(X); gets done inside the ISRx for each interrupt which also sets that flag true
  // but the other detachInterrupt(Y); has to be done manually based on those flags

  turnOffAllindicatorLEDs();
  pinMode(2,INPUT);                        //D2 INPUT & pullup not needed due to hardware pullups on RTC module
  pinMode(3,INPUT);                        //D3 INPUT & pullup off - the PIR module is controlling the HIGH/LOW status of this input line
  rtc_INT0_Flag = false;
  d3_INT1_Flag = false;
  
  noInterrupts();                          // waking from two interrupt sources requries them to be 'nested'
  
  bitSet(EIFR,INTF0);                      // before attachInterrupt(0,isr,xxxx) you must clear int0 flag inside 328p processor
  attachInterrupt(0,rtc_d2_alarm_ISR,LOW); // RTC alarm on D2  // LOW assures it will always respond if the RTC alarm is asserted

  bitSet(EIFR,INTF1);                      // clear int1 flag
  attachInterrupt(1,input_d3_interrupt_ISR,RISING);   //PIR drives its output line HIGH when it detects motion
  
  interrupts ();
  
  LowPower.powerDown(SLEEP_FOREVER, ADC_OFF, BOD_OFF); // ADC_ON simply preserves whatever the current ADC status is (in our case it's already OFF...)

  if (d3_INT1_Flag) {        // d3_INT1_Flag is set true in input_d3_interrupt_ISR()
       if (d3_INT1_eventCounter < 65532) {d3_INT1_eventCounter++;}  // only increment our counter variable if it's below the uint16_t max
                                                                    // this is somewhat unnecessary given the sensor has a 2-second reset time...
   // Pip 'bright' blue LED to indicate PIR driven wakeup event
      #if defined(LED_r9_b10_g11_gnd12) 
        digitalWrite(10,HIGH); pinMode(10,OUTPUT);        // OUTPUT mode = "BRIGHT" blue LED pip for PIR trigger  - must have limit resistor!
      #elif defined(LED_GndGB_A0_A2)
        turnOnBlueLED();                                  // regular "dim" Blue LED = pinMode(A2,INPUT_PULLUP);
      #endif
      LowPower.powerDown(SLEEP_15MS, ADC_OFF, BOD_OFF);   // time to view LED pip
      turnOffAllindicatorLEDs(); 
          
    } else { // If d3_INT1_Flag is still false then we woke from the RTC alarm - not the PIR, so Int1 still needs detached
       detachInterrupt(1);
    }

  if (rtc_INT0_Flag){       // rtc_INT0_Flag is set true in rtc_d2_alarm_ISR()
      Wire.beginTransmission(DS3231_ADDRESS);
      Wire.write(DS3231_STATUS_REG);
      Wire.write(0);      // turns Off (both) RTC alarms
      Wire.endTransmission();
      // NOTE: do not set rtc_INT0_Flag = false; here! //must wait till AFTER we break out of counting while loop
      // because: while (rtc_INT0_Flag == false) { is the "sub-loop" that acts as the PIR event counter    
  } else { // If rtc_INT0_Flag is still false then we woke from the PIR - not the RTC - so Int0 still needs to be detached
      detachInterrupt(0);
  }
  
} // terminates void sleepNwait4D3Interrupt(){

void input_d3_interrupt_ISR() {
  d3_INT1_Flag = true;
  detachInterrupt(1);
}
#endif  //#if defined(PIRcountPerInterval_2byte)

//==========================================================================================
//  *  *  *  *  *  *  *  *  *  FUNCTIONS called during Setup()  *  *  *  *  *  *  *  *  *  * 
//==========================================================================================

void setup_sendboilerplate2serialMonitor(){      
//-----------------------------------------------------------------------------------------
//NOTE:(__FlashStringHelper*) is needed to print variables is stored in PROGMEM instead of regular memory
//  internal eeprom stores 0-1023 bytes:
//  first 0-63 =64 bytes reserved for logger parameters & constants

  Serial.print(fileNAMEonly); // or use Serial.println((__FlashStringHelper*)codebuild); for the entire path + filename
  Serial.print(F("   "));Serial.print((__FlashStringHelper*)compileDate);
  Serial.print(F(" @")); Serial.println((__FlashStringHelper*)compileTime);
  
    char OnecharBuffer; // retrieve & send 100 character info fields stored in 328p internal eeprom 
    Serial.print(F("Logger:, ")); //Serial.println((__FlashStringHelper*)loggerConfiguration);
    for (uint16_t k = 64; k < 165; k++) { OnecharBuffer = EEPROM.read(k); Serial.print(OnecharBuffer); }

    // The ASCII code for a blank space is decimal 32 which disables the output
    // unformatted eeprom usually contains 255 which prints as ÿ (y with a diaeresis) this also surpresses output
    byteBuffer1 = EEPROM.read(266);
    if(byteBuffer1!=255 && byteBuffer1!=32){ // checks prevent serial output if text field is empty    Serial.println();
    Serial.print(F("Calibrated:, "));
    for (uint16_t k = 266; k < 367; k++) { OnecharBuffer = EEPROM.read(k); Serial.print(OnecharBuffer); }
    }
    
    Serial.println();
    Serial.print(F("Deployment:, "));
    for (uint16_t k = 165; k < 266; k++) { OnecharBuffer = EEPROM.read(k); Serial.print(OnecharBuffer); }

    byteBuffer1 = EEPROM.read(367);  // unformatted eeprom usually contains 255 which prints as ÿ (y with a diaeresis)
    if(byteBuffer1!=255 && byteBuffer1!=32){             // check prevents serial display if text field is still empty
    Serial.println();   
    Serial.print(F("Site info:, "));
    for (uint16_t k = 367; k < 468; k++) { OnecharBuffer = EEPROM.read(k); Serial.print(OnecharBuffer); }
    }
    Serial.println();Serial.flush();

//  remaining 512 to 1023 for fonts(?) on loggers with OLED screens
}

void setup_displayStartMenu() {       
//-----------------------------------------------------------------------------------------

    clearSerialInputBuffer;                           // this just clears out any residual data in serial send buffer before starting our menu  
    Serial.setTimeout(1000);                          // 1000 milliseconds is the default timeout for the Serial.read(); command
    uint8_t inByte=0;
    boolean wait4input = true;
    boolean displayMenuAgain = true;
    uint32_t startMenuStart = millis();                          //Beginning of time-out period must be unsigned long variable

  do{ inByte=0;
    if (displayMenuAgain) { 
      startMenu_printMenuOptions(); displayMenuAgain=false;}

    if (Serial.available()) { 
      inByte = Serial.parseInt(); }                     //from https://forum.arduino.cc/t/simple-serial-menu-without-a-library/669556
    
    switch (inByte) {                                   //NOTE: switch can also accept 'letter inputs' with single quotes: case 'Z':
            case 99:
              displayMoreOptions = !displayMoreOptions; // toggles the boolean true/false variable  
              Serial.setTimeout(1000); displayMenuAgain=true;  break;
            case 1:
              startMenu_sendData2Serial(true);  
              displayMenuAgain=true;  break;
            case 2:
              startMenu_setRTCtime(); 
              Serial.setTimeout(1000); displayMenuAgain=true;  break;
            case 3:
              startMenu_setSampleInterval(); 
              Serial.setTimeout(1000); displayMenuAgain=true;  break;
            case 4:
              startMenu_updateLoggerInfoField(2,165,265); // updateDeploymentInfo  (SwitchText,EEstart,EEend)
              Serial.setTimeout(1000); displayMenuAgain=true; break;
            case 5:
              ECHO_TO_SERIAL = !ECHO_TO_SERIAL;           // toggles SERIAL Output On/Off
              displayMenuAgain=true;  break;  
            case 6:                                       // START logger operation
              wait4input=false; break;                    // wait4input=false breaks you out of the switch-case loop & sends you back to Setup function where displayStartMenu was first called
            case 7:
              startMenu_updateLoggerInfoField(4,367,467);  // update Site Info 
              Serial.setTimeout(1000); displayMenuAgain=true; break;                        
            case 8:
              startMenu_updateLoggerInfoField(1,64,164);  // update Logger Hardware info 
              Serial.setTimeout(1000); displayMenuAgain=true; break;    
            case 9:
              startMenu_updateLoggerInfoField(3,266,366); // Set Cal. Constants //was updateCalibrationInfo 
              Serial.setTimeout(1000); displayMenuAgain=true; break;
            case 10:
              startMenu_setVrefConstant(); 
              Serial.setTimeout(1000); displayMenuAgain=true;  break; 
            case 11:
              startMenu_setRTCageOffset(); 
              Serial.setTimeout(1000); displayMenuAgain=true;  break; 
            case 12:
              startMenu_sendData2Serial(false);             // DLoad ALL RAW bytes from External EEprom
              displayMenuAgain=true;  break;                // outputs ALL eeprom memory as RAW bytes - useful for spotting code / pointer problems
            case 13:           
              error_shutdown();                  
            default:                                      // Check milliseconds elapsed & send logger into shutdown if we've waited too long
                if ((millis() - startMenuStart) > 480000) {// start menu has an 480000 = 8 minute timeout
                Serial.println(F("Start Menu Timed out with NO commands!"));
                Serial.println(F("Logger shutting down...")); Serial.flush(); error_shutdown(); 
                }
              break;
         }    //  terminates switch-case cascade
      }while(wait4input);                   //  do-while loops back to check for input if wait4input=true;
  return;
}

void startMenu_printMenuOptions(){          
//-----------------------------------------------------------------------------------------
// note: setup_sendboilerplate2serialMonitor(); runs once on startup before this

  Serial.println();
  RTC_DS3231_getTime();                     // reads current clock time  and display it via CycleTimeStamp
    if(t_year==2000){Serial.print(F("*"));} // flags need for clock set
  Serial.print(t_year,DEC);Serial.print(F("/"));Serial.print(t_month,DEC);Serial.print(F("/"));Serial.print(t_day,DEC);
    if(t_year==2000){Serial.print(F("*"));} // flags need for clock set
  Serial.print(F(" Time:")); Serial.print(t_hour,DEC);Serial.print(F(":"));Serial.print(t_minute,DEC);
  Serial.print(F(":"));Serial.print(t_second,DEC); //seconds separate because usually value is zero
  EEPROM.get(6,InternalReferenceConstant); // use .get for multi-byte variables
  Serial.print(F("  VREF:"));Serial.print(InternalReferenceConstant);
  #ifndef LowMemoryCompile
    if(InternalReferenceConstant==1126400){Serial.print(F("(Set?) "));}
  #endif
  RTCagingOffset = EEPROM.read(10);        // use .read for single-byte reads
  Serial.print(F("  RTCage:"));Serial.print(RTCagingOffset);
  #ifndef LowMemoryCompile
    if(RTCagingOffset==0){Serial.print(F("(?)"));}Serial.println();
  #endif
  Serial.print(F("Logging: "));
  startMenu_listEnabledSensors();
  //POWER OF TWO error check - any non zero result in if statement is interpreted as 'true' 
    if (sensorBytesPerRecord &(sensorBytesPerRecord-1)){ 
      Serial.println();Serial.print(sensorBytesPerRecord);
      Serial.println(F(" Sensor bytes/rec not PowerOfTwo → MUST CHANGE CONFIG!"));Serial.println();
      Serial.flush();error_shutdown();
      }
  Serial.println();
  
  SampleIntervalMinutes = EEPROM.read(4);
  SampleIntervalSeconds = EEPROM.read(5); 
  Serial.print(F("RUNtime: "));Serial.print(totalBytesOfStorage);
  Serial.print(F(" / "));Serial.print(sensorBytesPerRecord);Serial.print(F("recBytes @ "));
    if (SampleIntervalMinutes==0){Serial.print(SampleIntervalSeconds);Serial.print(F("sec"));}else{Serial.print(SampleIntervalMinutes);Serial.print(F("min"));}
    Serial.print(F(" ~ "));
    floatBuffer = ((totalBytesOfStorage)/sensorBytesPerRecord);
    if (SampleIntervalMinutes==0){
              floatBuffer = floatBuffer*SampleIntervalSeconds;
              Serial.print(floatBuffer/60,0);Serial.print(F("m or "));
              Serial.print(floatBuffer/3600,1);Serial.print(F("h"));
            } else {
              floatBuffer = floatBuffer*(60U*SampleIntervalMinutes); //was UL?
              uint16_Buffer = (int)(floatBuffer/86400);
              if (uint16_Buffer>1){
                Serial.print(uint16_Buffer);Serial.print(F("d"));
                } else {
                Serial.print(floatBuffer/3600,1);Serial.print(F("h"));
                }
            }
    Serial.println();

    Serial.println();
    if(displayMoreOptions){Serial.print(F("Setup & Testing:"));
      }else{Serial.print(F("Runtime Options:"));}
            
    sendMultiAscii2serial(8,32);// blank spaces
    Serial.print(F("Serial Output["));
    Serial.print(ECHO_TO_SERIAL ? "ON] " : "Off]"); 
    sendMultiAscii2serial(4,32);// blank spaces
    Serial.print(F("[99] →"));  
    
    if(displayMoreOptions){Serial.print(F("Runtime"));
      }else{Serial.print(F("Setup"));}
    Serial.println(F(" Menu"));   
    
    sendMultiAscii2serial(65,45);Serial.println();      // line of -minus signs
    Serial.print(F(" [1]  DOWNLOAD Data     "));
    if((DS3231_PowerLossFlag) || (t_year==2000)){   //Oscillator Stop Flag (OSF). A logic 1 in bit7 indicates
    Serial.print      (F("[2]**Set RTC time**"));}//that the oscillator was stopped for some period due to power loss
    else {Serial.print(F("[2]  Set RTC Clock "));}
    Serial.println(F("   [3]  Set INTERVAL"));
    Serial.println(F(" [4]  Deployment info   [5]  SERIAL On / Off  [6]  START logging"));

if(displayMoreOptions){    
    sendMultiAscii2serial(65,45);Serial.println();      // line of -minus- signs
    Serial.println(F(" [7]  Add Site info     [8]  Add Logger info  [9]  Cal.Constants"));
    Serial.println(F(" [10] Set VREF          [11] Set RTC Aging    [12] Dload RAW EEdata"));
    Serial.println(F(" [13] SHUTDOWN"));
    }
      Serial.println(); Serial.flush();
}   //terminates startMenu_printMenuOptions
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
