Nishuy52/iex-coral-datalogger/(commit log)

2025-11-04 Update README with Cave Pearl's Project reference
    Added a reference to the Cave Pearl's Project schematics.
2026-06-11 Add standalone verification test sketches for batch QC
    Seven numbered sketches matching build stages: blink/bootloader, I2C scan,
    RTC register test, EEprom write/verify, Vcc calibration, sleep current,
    deployment sensor check. All run at 500000 baud to match the main sketch.
2026-06-11 Add staged batch build and verification instructions
2026-06-11 Add printable per-unit QC checklist
2026-06-11 Group BOM by sensor/subsystem with per-component wiring targets
2026-06-11 Add dated prototype build plan for 27 Jun deadline
2026-06-11 Embed step reference photos from the Cave Pearl tutorial in build stages
2026-06-11 Add printable PDF renders of instructions and QC checklist
2026-06-20 Add external I2C EEprom expansion instructions (Appendix B)
2026-06-20 Add shared I2C bus wiring section with diagram for sensors + EEprom
2026-06-20 Add BURNIN/DEPLOY/CORETEST profile sketches; harden I2C bus-hang handling
    - Add the three per-profile copies of the logger sketch
    - Move Serial.begin() to the top of setup() + add a boot print, so a stuck
    I2C bus (e.g. a miswired sensor holding SDA/SCL low) can no longer hang
    setup() before serial starts and silently blank the monitor
    - Add Wire.setWireTimeout(25ms, auto-reset) after Wire.begin() in all three
    sketches and in 02_I2C_Scanner so a held bus fails fast instead of hanging
    [02_I2C_Scanner.ino, 2-Part_Logger_BURNIN.ino, 2-Part_Logger_CORETEST.ino, 2-Part_Logger_DEPLOY.ino]
2026-07-25 Revise build docs, add IDE setup section; reorganize sketches
    - INSTRUCTIONS: new Arduino IDE setup section (CP2102 driver install,
    board/processor/port config); LED + NTC/LDR circuit now required;
    drop reset-switch removal and flux-clean steps; power-LED resistor
    step updated with board-specific location (472 above regulator)
    - CHECKLIST/BUILD_PLAN aligned with the Stage 1 changes; PDFs re-rendered
    - DEPLOY sketch: storage defines switched to external 64k AT24C512 EEprom
    - Move FalconTubeLogger sketch into its own folder for Arduino IDE
    - Add analysis/ EEprom-dump parsing notes and scripts
    [capture.csv]
2026-07-25 Make external 64k EEprom the DEPLOY storage; retire DEPLOY-XL docs
    The DEPLOY sketch already logs to the AT24C512 at 0x50, so fold the
    DEPLOY-XL profile into DEPLOY across the docs:
    - INSTRUCTIONS: two profiles instead of three; DEPLOY block carries the
    0x50/65536 storage defines; run length now 8192 records (~85 days at
    15 min); Appendix B no longer [OPTIONAL] - the 64k chip is standard
    Stage 5 hardware for deployment units; wiring section, address table
    and troubleshooting updated; stale/renamed anchors fixed
    - i2c_bus_wiring.svg: EEprom drawn as a required device (AT24C512)
    - CHECKLIST: external EEprom row now required; profile row expects
    65536 B storage at startup
    - BUILD_PLA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
    [02_I2C_Scanner.ino]
