Nishuy52/iex-coral-datalogger/(notices)

Notices in the files:
2-Part_Logger_DEPLOY/2-Part_Logger_DEPLOY.ino:
modified from JeeLab's fantastic real time clock library released into the public domain
